p20130222/test/得利卡-車頂燈架 - 複製/成品版本/生產單_22.10.26/焊接照片/1794E184-5D2B-4A6E-A307-405944A45CD0.jpg

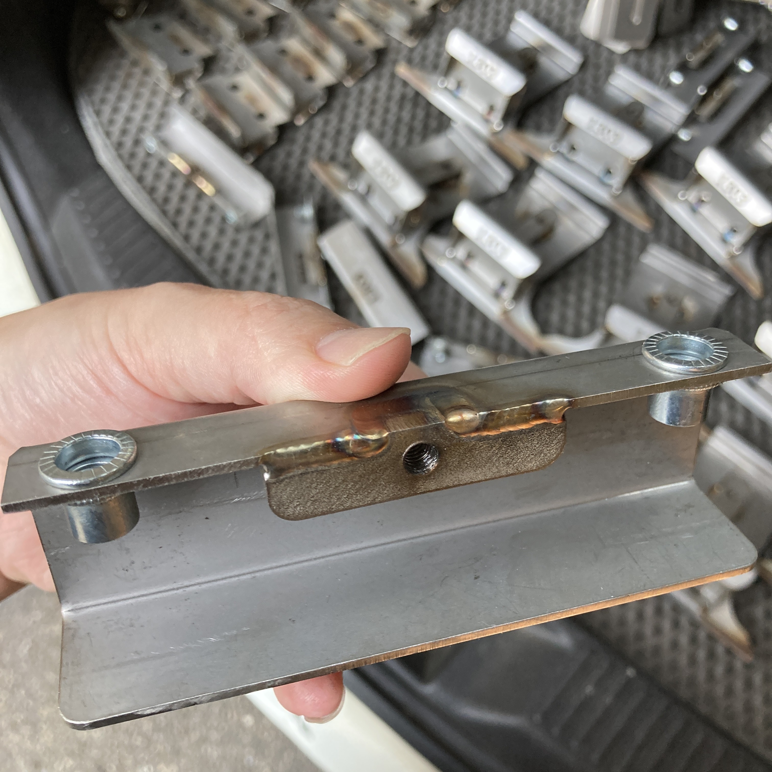
得利卡-車頂燈架 - 複製/成品版本/生產單_22.10.26/焊接照片/1794E184-5D2B-4A6E-A307-405944A45CD0.jpg
