p20130222/test/得利卡-車頂燈架 - 複製/成品版本/生產單_22.10.26/焊接照片/E42CDD00-9727-4BCB-AF38-9A98A2779EEC.jpg

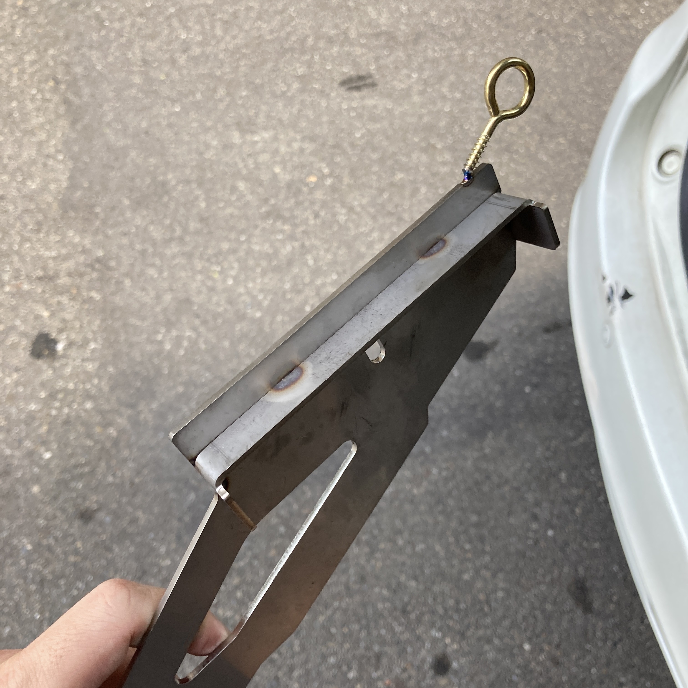
得利卡-車頂燈架 - 複製/成品版本/生產單_22.10.26/焊接照片/E42CDD00-9727-4BCB-AF38-9A98A2779EEC.jpg
