p20130222/test/得利卡-車頂燈架 - 複製/成品版本/生產單_22.07.14/短-車頂燈架-組合(v220714)/加工說明/加工說明.pptx

## 1. 修毛邊【手磨】 ( 海綿砂布 )

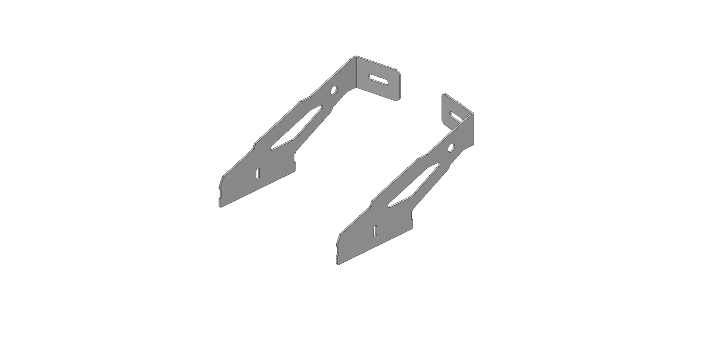
[picture p3: figure]

A 組件

Notes: 1.本體修毛邊

## 1.焊接組件 ( 注意方向 )

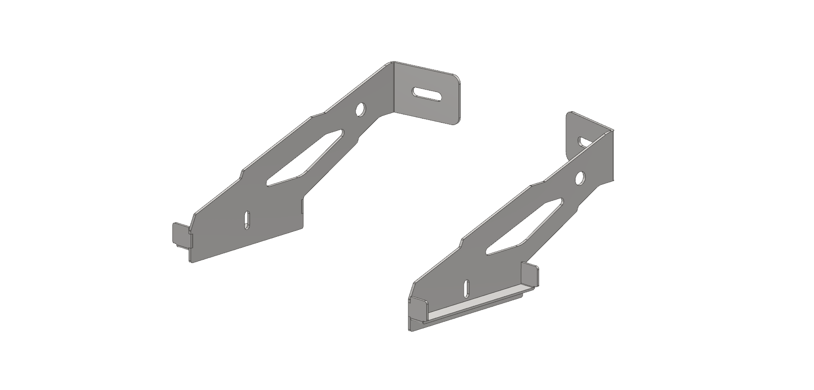
[picture p4: figure]

A 組件

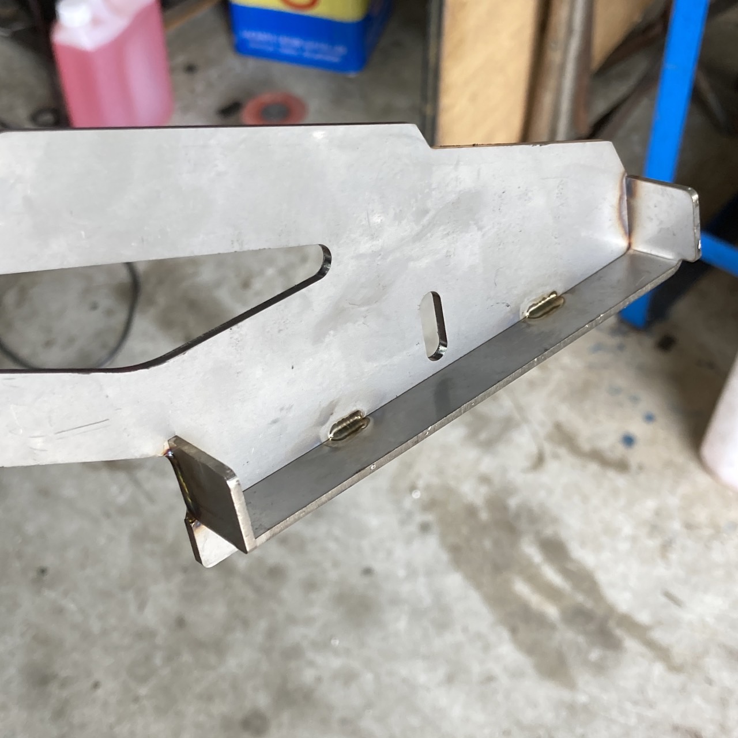
[picture p5: figure]
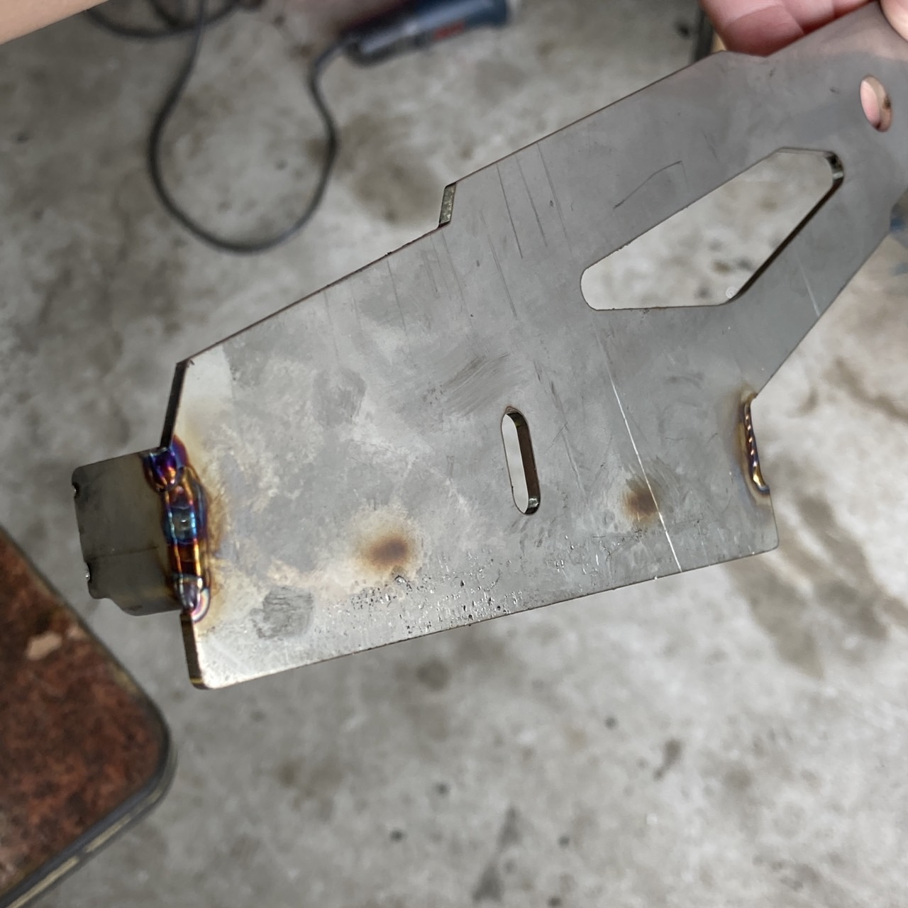
[picture p6: figure]
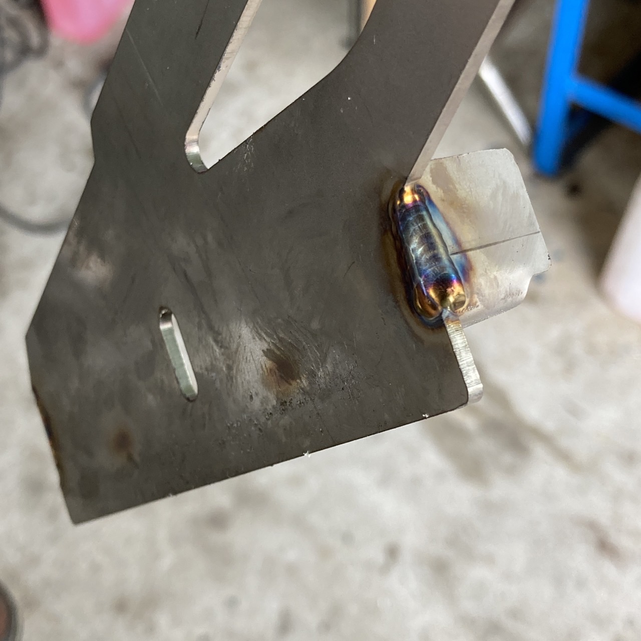
[picture p7: figure]
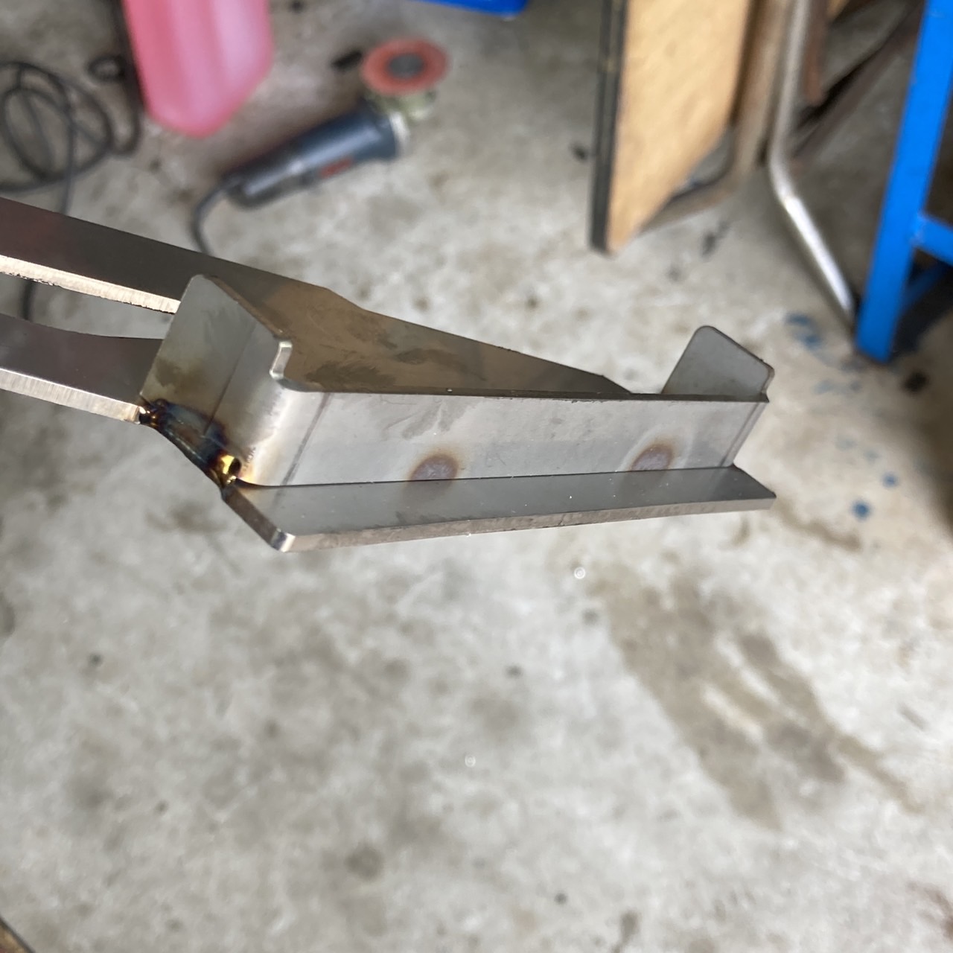
[picture p8: figure]

## 1.焊接羊眼圈 完成

A 組件

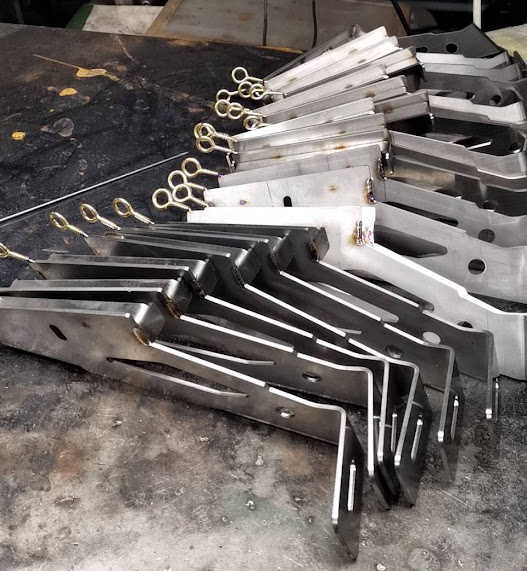
[picture p9: figure]

## 1. 攻牙機攻牙M6

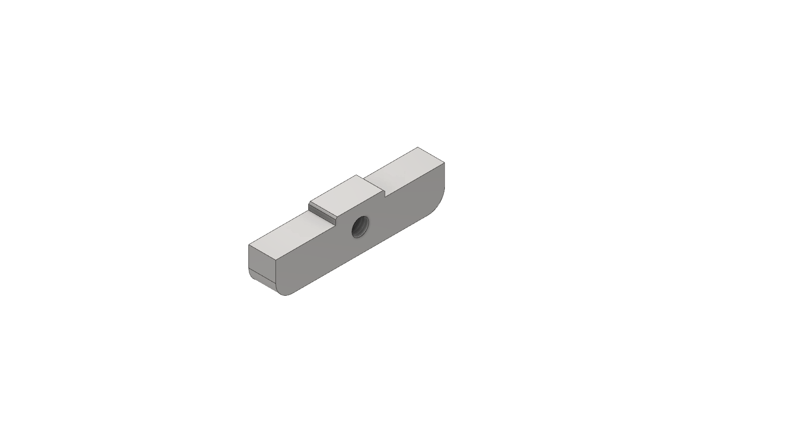
[picture p10: figure]

B組件

Notes: 1. 機器導角單邊
2. 機器攻牙M6

## 1. 本體修毛邊 【機磨】(散打#240 ) 2.鑽孔-拉帽孔擴大為D11 (現為D6 )

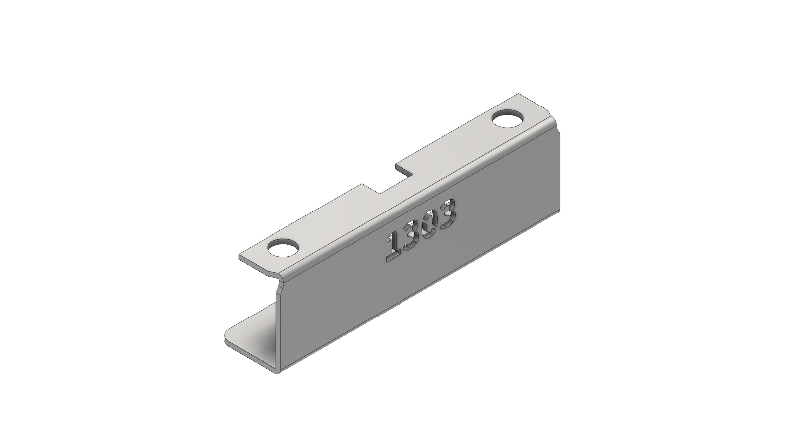
[picture p11: figure]

B組件

Notes: 1.鑽孔-拉帽孔擴大為D11 (現為D10 )

## 1.焊接牙片( 滿焊，注意垂直面 ) 2.牙孔倒角 3.牙孔重新手工攻牙 4.拉上M8拉帽 5.清洗攻牙油 完成

B組件

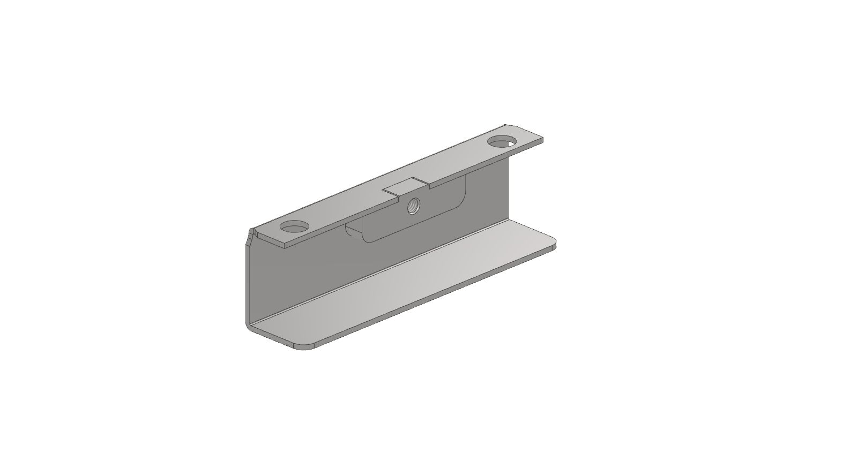
[picture p12: figure]
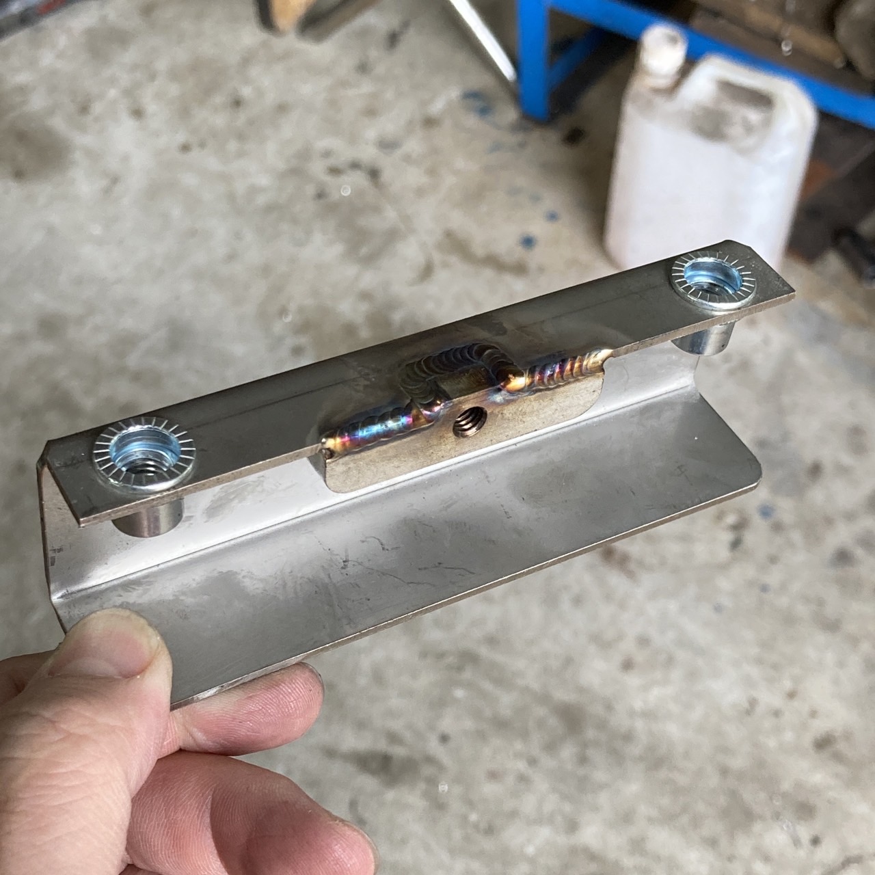
[picture p13: figure]

Notes: 1. 焊接牙片(滿焊)
2.牙孔倒角
3.牙孔重新手工攻牙

## Slide 7

B組件

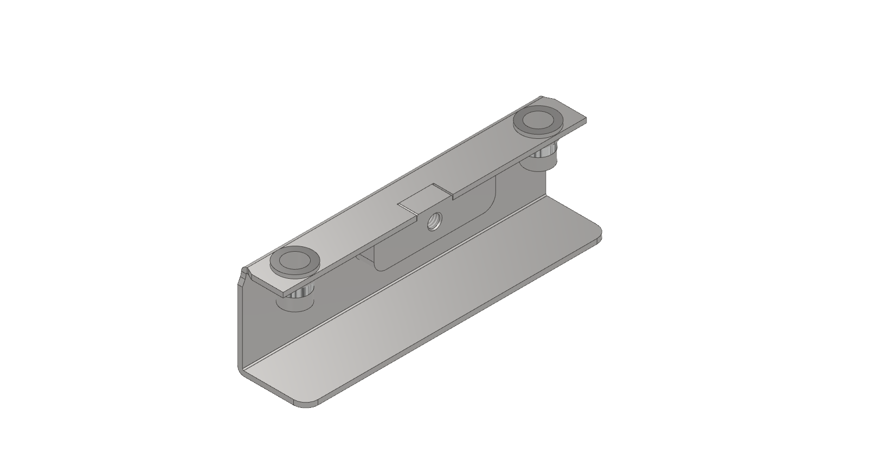
[picture p14: figure]

A組件

Notes: 拉上拉帽
點焊拉帽
清洗攻牙油

## 烤漆前處理 1.賭塞牙孔-寄上烤漆用螺絲 2.送烤漆 3.烤漆完成後折斷羊眼釘 完成

Notes: 1.賭塞牙孔-寄上烤漆用螺絲
2.送烤漆
3.烤漆完成後折斷羊眼釘

## Slide 9

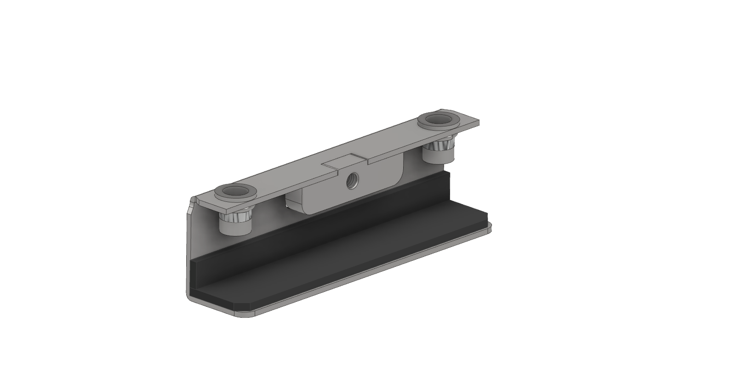
[picture p15: figure]
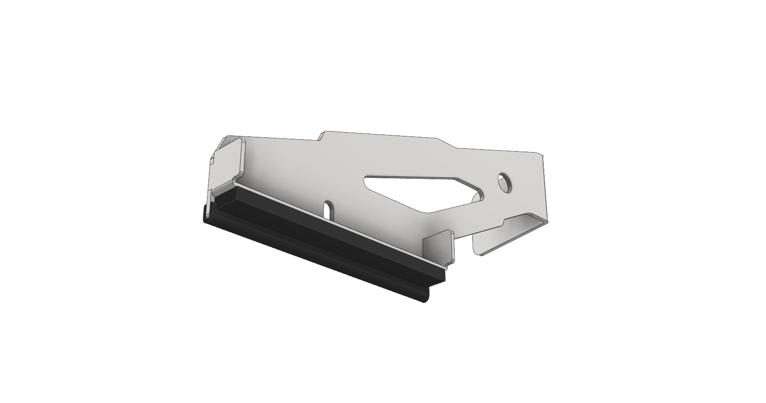
[picture p16: figure]

Notes: 1.黏貼軟墊、U形條

## Slide 10

Notes: 1.鎖上螺絲 ( 不上螺絲膠)
