p20130222/test/得利卡-車頂燈架 - 複製/成品版本/生產單_22.07.14/短-車頂燈架-組合(v220714)/加工說明/排燈架加工說明.pdf

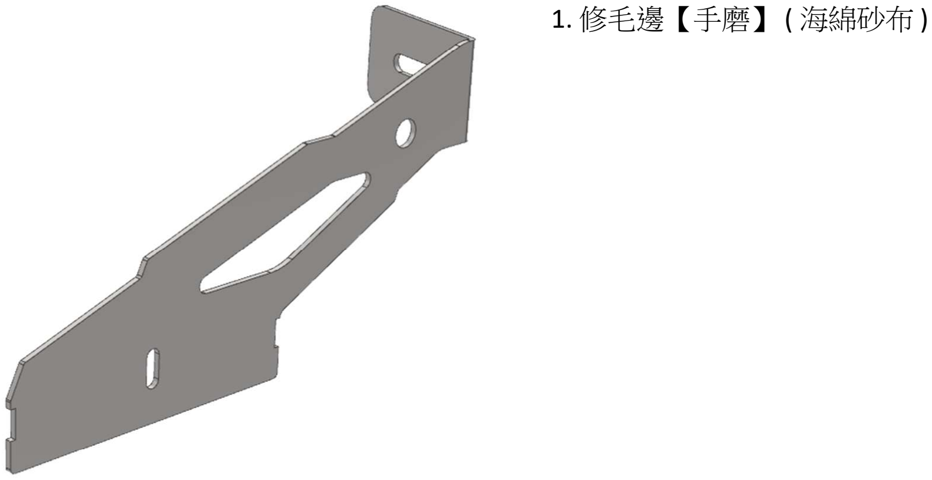
[picture p17: page 1]

### 1. 修毛邊【手磨】 ( 海綿砂布 )

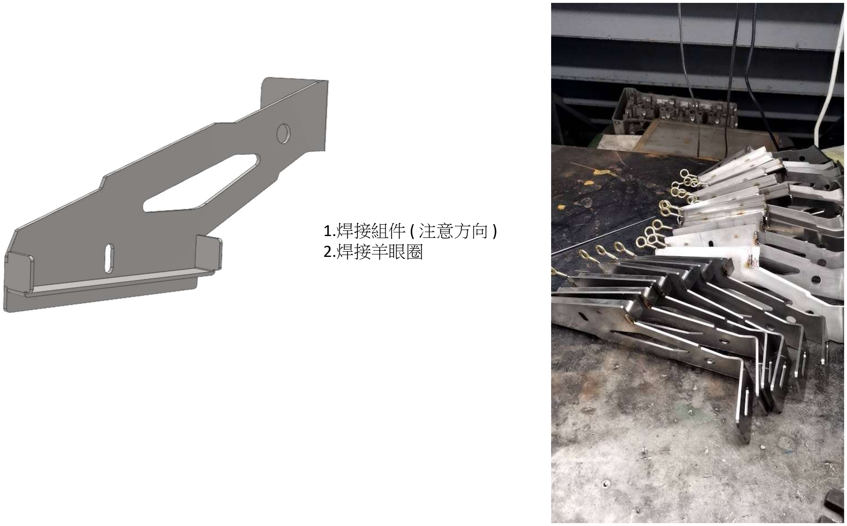
[picture p18: page 2]

1.焊接組件 ( 注意方向 )
2.焊接羊眼圈

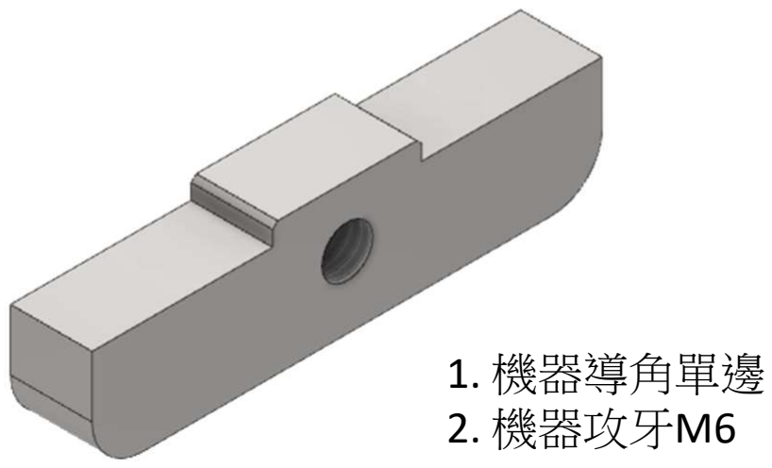
[picture p19: page 3]

### 1. 機器導角單邊

### 2. 機器攻牙M6

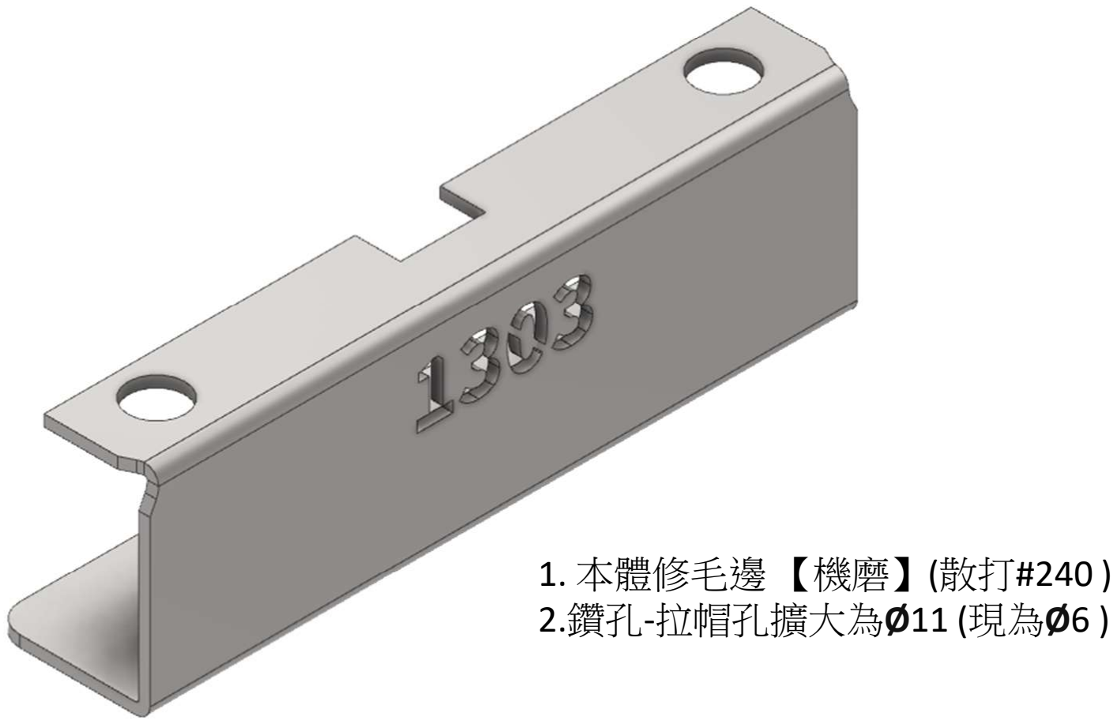
[picture p20: page 4]

### 1. 本體修毛邊 【機磨】(散打#240 )

### 2.鑽孔-拉帽孔擴大為Ø11 (現為Ø6 )

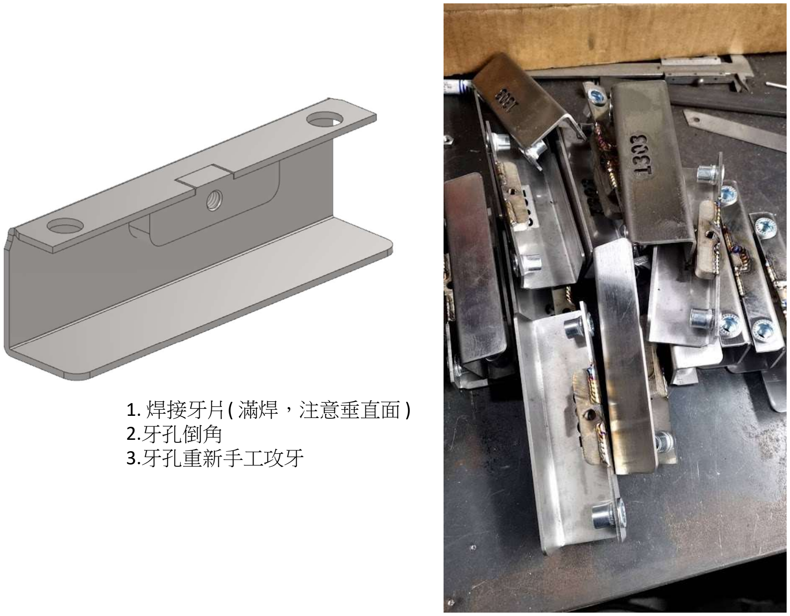
[picture p21: page 5]

### 1. 焊接牙片( 滿焊，注意垂直面 )

2.牙孔倒角
3.牙孔重新手工攻牙

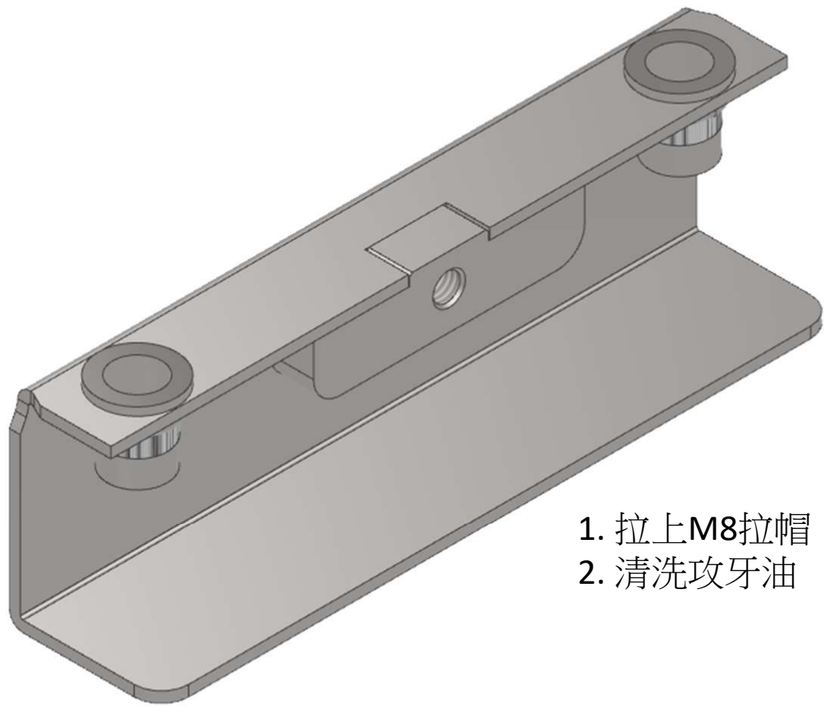
[picture p22: page 6]

### 1. 拉上M8拉帽

### 2. 清洗攻牙油
