p20130222/test/得利卡-車頂燈架 - 複製/IMG_3658.jpg

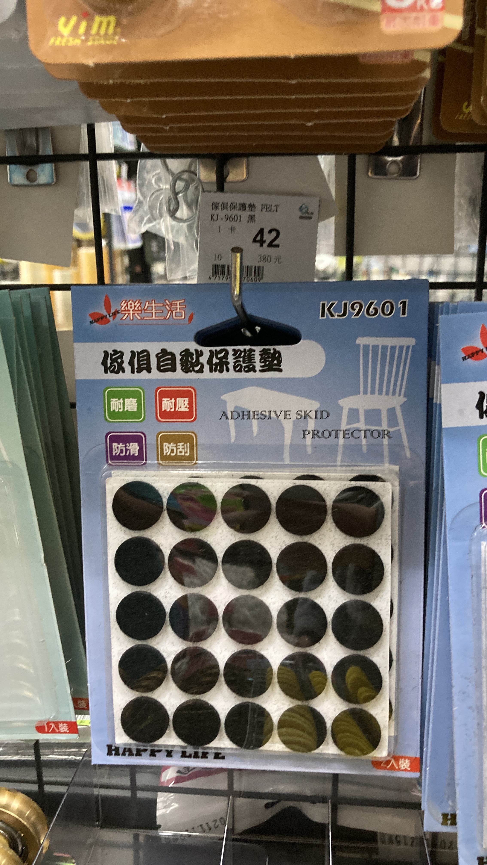
得利卡-車頂燈架 - 複製/IMG_3658.jpg
