p20130222/test/得利卡-車頂燈架 - 複製/成品版本/成品-膠墊使用後情境.jpg

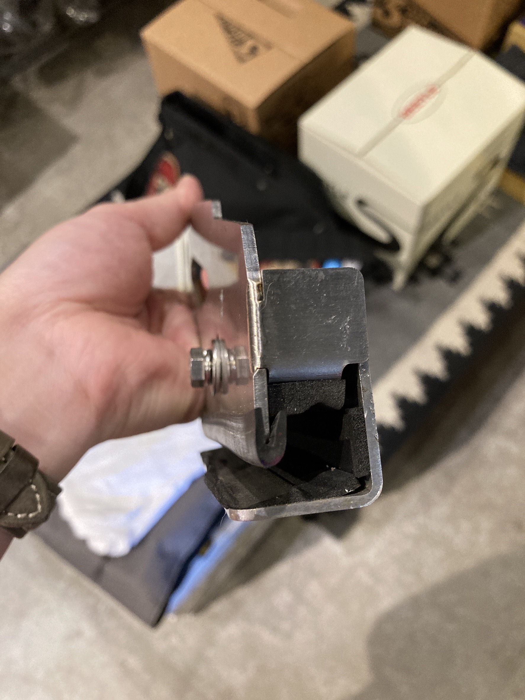
得利卡-車頂燈架 - 複製/成品版本/成品-膠墊使用後情境.jpg
