p20130222/test/得利卡-車頂燈架 - 複製/成品版本/生產單_22.01.05/下單郵件附件.jpg

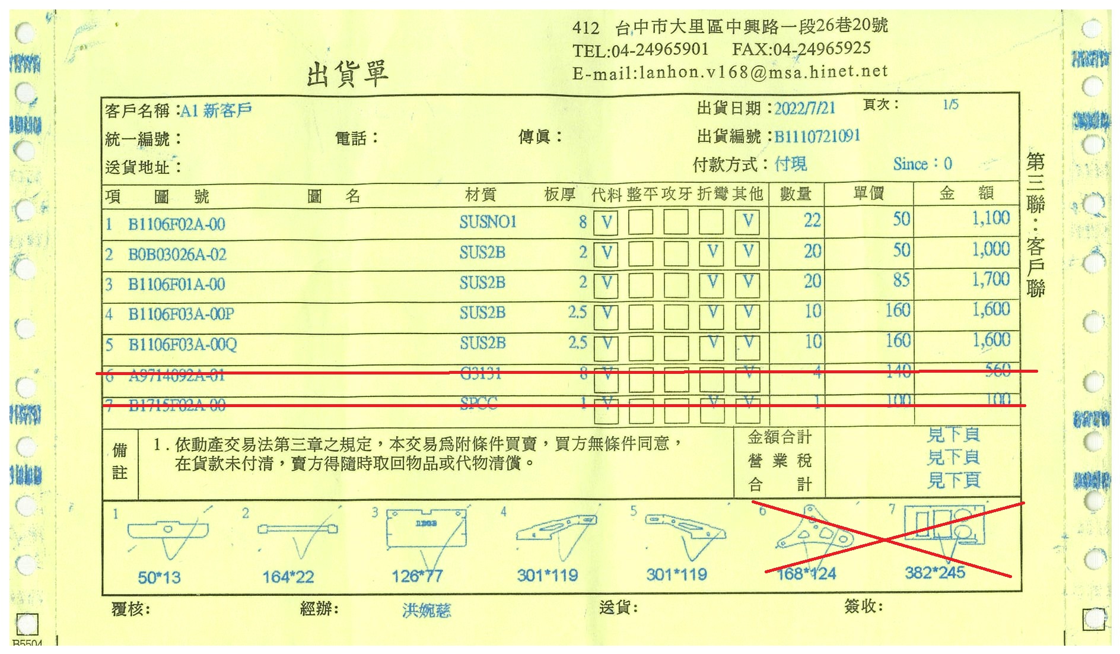
得利卡-車頂燈架 - 複製/成品版本/生產單_22.01.05/下單郵件附件.jpg
