p20130222/test/得利卡-車頂燈架 - 複製/成品版本/生產單_22.07.14/短-車頂燈架-組合(v220714)/加工說明/IMG_3508.JPG

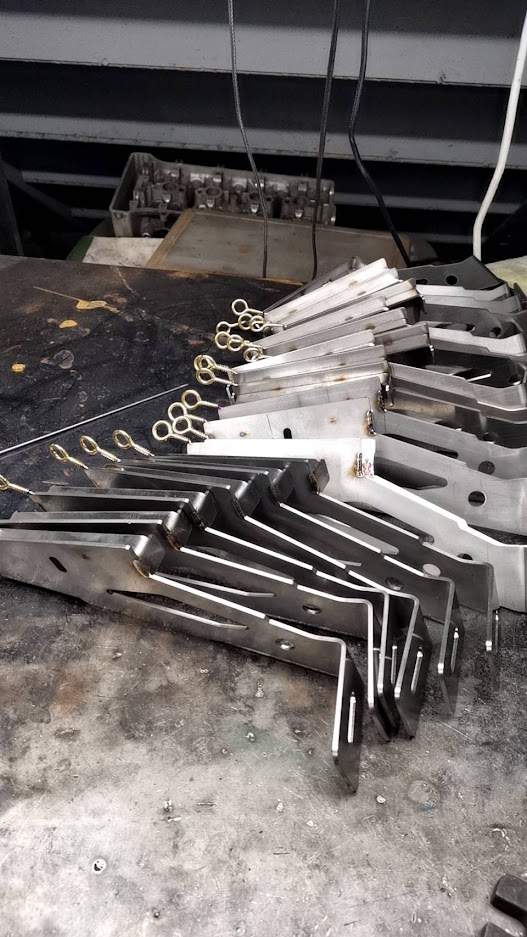
得利卡-車頂燈架 - 複製/成品版本/生產單_22.07.14/短-車頂燈架-組合(v220714)/加工說明/IMG_3508.JPG
