p20130222/test/得利卡-車頂燈架 - 複製/成品版本/生產單_22.10.26/採購物品/寶家 (5).jpg

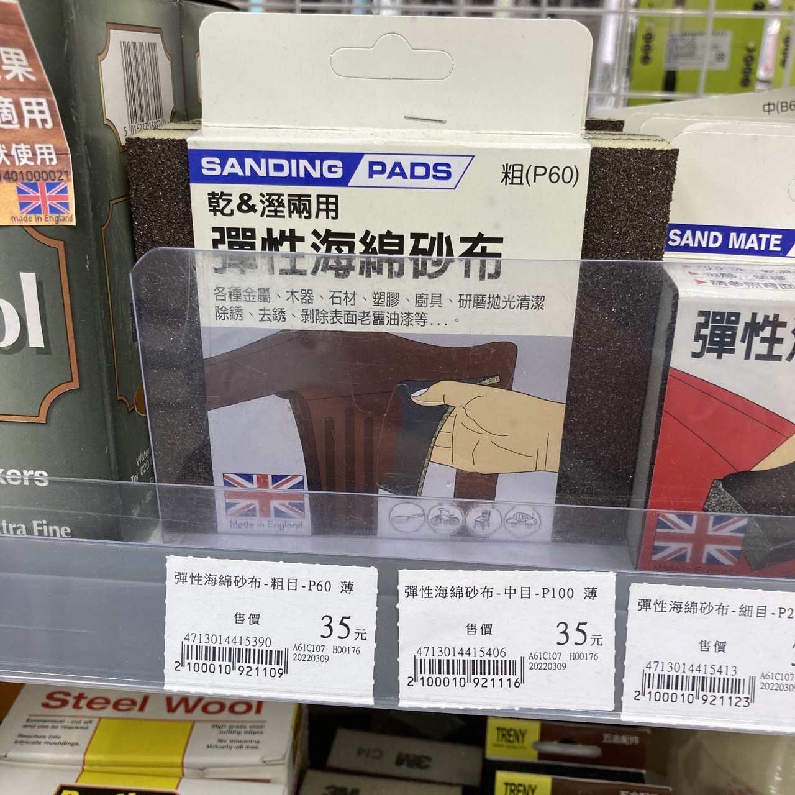
得利卡-車頂燈架 - 複製/成品版本/生產單_22.10.26/採購物品/寶家 (5).jpg
