p20130222/test/得利卡-車頂燈架 - 複製/成品版本/生產單_22.10.26/焊接照片/2563458F-2E07-4B0C-8D35-3437E1A50A45.jpg

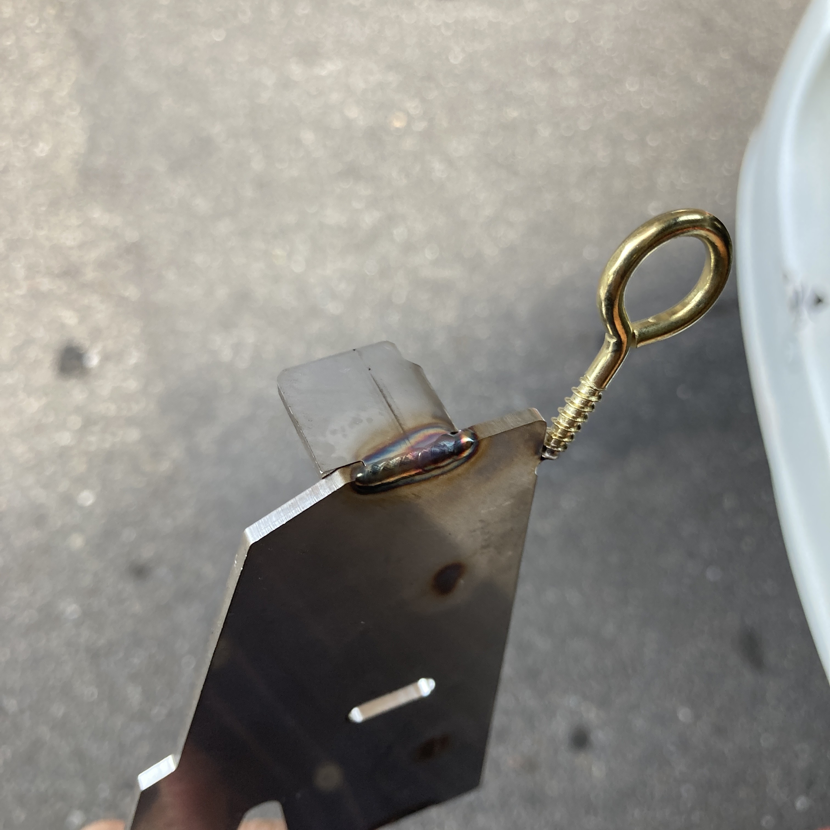
得利卡-車頂燈架 - 複製/成品版本/生產單_22.10.26/焊接照片/2563458F-2E07-4B0C-8D35-3437E1A50A45.jpg
