p20130222/test/得利卡-車頂燈架 - 複製/成品版本/生產單_22.10.26/焊接照片/87878100-F892-40EC-8713-8FCF032992BB.jpg

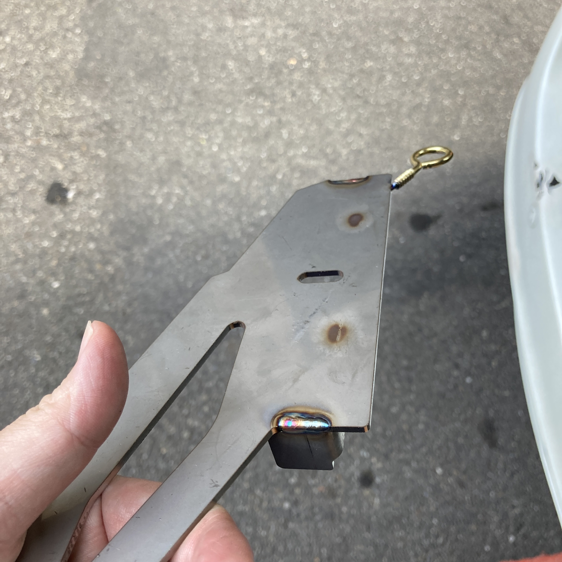
得利卡-車頂燈架 - 複製/成品版本/生產單_22.10.26/焊接照片/87878100-F892-40EC-8713-8FCF032992BB.jpg
