p20130222/test/得利卡-車頂燈架 - 複製/成品版本/生產單_22.10.26/焊接照片/F7BDDE9E-6D32-4605-A794-7535F89AB357.jpg

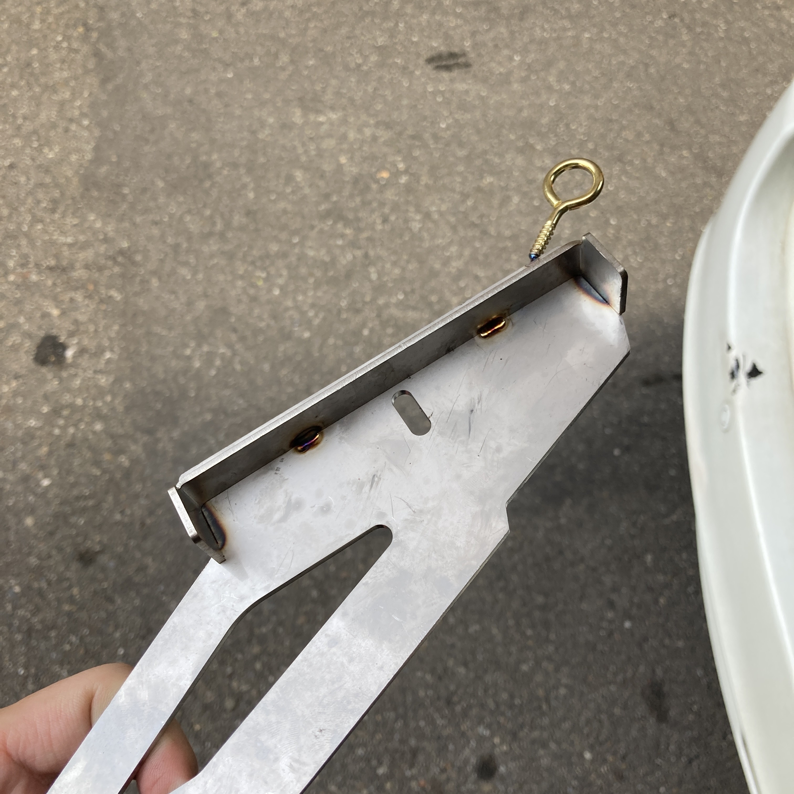
得利卡-車頂燈架 - 複製/成品版本/生產單_22.10.26/焊接照片/F7BDDE9E-6D32-4605-A794-7535F89AB357.jpg
