p20130222/test/得利卡-車頂燈架 - 複製/得利卡-車頂燈架.xlsx

Sheet: 22.10.26_車頂燈架-報價
報 價 單
客戶: | May club |  |  | 專案: |  | 得利卡車頂燈架 |  |  | 報價日期 : |  | 2022.10.26
聯絡人: | Gavin Chiu |  |  | 電 話 : |  |  |  | 傳 真 :
交貨方式: | 配送 |  |  | 送貨地址 : |  | May club 店址
品 名 |  | 項 目 |  |  | 材質 |  | 單位 | 數量 | 單 價 |  | 小 計
得利卡車頂燈架 |  | 吊架-短 (R)、(L) |  |  | 白鐵 / 2.5mm |  | 組 | 10 | 2210 |  | 22100
版本: (#01.05) |  | 烤漆 - 砂面消光黑
注意事項 * 拉帽加工，需特別留意 * M6牙片機器攻牙後，焊接，再重複手攻牙
備註: *無開立發票 交期: 下單後預計天數 15~20 工作天
 |  |  |  |  |  |  |  |  | 總計 | $22100
車頂燈架 - 短 (R)、(L)
版本: (#01.05)
匯款資料 |  |  | 備註
銀行帳戶 | 822 | 中國信託 | 1.本報價單經報價單位簽章後始生效。
銀行帳號 | 9015-6030-1539 |  | 2.以上報價經貴公司代表人、採購窗口簽認回傳後，即視為正式訂購單契約始生效。
戶名 | 柯舜傑 |  | 3. 報價有效期限 / 2個月
付款方式
訂單內容確認無誤後，支付訂金50%以完成下單開始執行生產。 交貨時支付尾款。
 |  |  |  |  |  |  |  | 007
聯絡方式 |  |  |  |  |  |  | 客戶確認簽章 / 日期
手機: | 0970-798-959
Line ID : | p71042013
E-mail : | p20130222@gmail.com

Sheet: 22.07.12_車頂燈架-報價
報 價 單
客戶: | May club |  |  | 專案: |  | 得利卡車頂燈架 |  |  | 報價日期 : |  | 2022.07.12
聯絡人: | Gavin Chiu |  |  | 電 話 : |  |  |  | 傳 真 :
交貨方式: | 配送 |  |  | 送貨地址 : |  | May club 店址
品 名 |  | 項 目 |  |  | 材質 |  | 單位 | 數量 | 單 價 |  | 小 計
得利卡車頂燈架 |  | 吊架-短 (R)、(L) |  |  | 白鐵 / 2.5mm |  | 組 | 10 | 1860 |  | 18600
版本: (#01.05) |  | 烤漆 - 砂面消光黑 |  |  |  |  | 組 | 10 | 350 |  | 3500
備註: *無開立發票 交期: 下單後預計天數 15~20 工作天
 |  |  |  |  |  |  |  |  | 總計 | $22100
車頂燈架 - 短 (R)、(L)
版本: (#01.05)
匯款資料 |  |  | 備註
銀行帳戶 | 822 | 中國信託 | 1.本報價單經報價單位簽章後始生效。
銀行帳號 | 9015-6030-1539 |  | 2.以上報價經貴公司代表人、採購窗口簽認回傳後，即視為正式訂購單契約始生效。
戶名 | 柯舜傑 |  | 3. 報價有效期限 / 2個月
付款方式
訂單內容確認無誤後，支付訂金50%以完成下單開始執行生產。 交貨時支付尾款。
 |  |  |  |  |  |  |  | 007
聯絡方式 |  |  |  |  |  |  | 客戶確認簽章 / 日期
手機: | 0970-798-959
Line ID : | p71042013
E-mail : | p20130222@gmail.com

Sheet: 22.01.04_車頂燈架-報價
報 價 單
客戶: | May club |  |  | 專案: |  | 得利卡車頂燈架 |  |  | 報價日期 : |  | 2022.01.04
聯絡人: | Gavin Chiu |  |  | 電 話 : |  |  |  | 傳 真 :
交貨方式: | 配送 |  |  | 送貨地址 : |  | May club 店址
品 名 |  | 項 目 |  |  | 材質 |  | 單位 | 數量 | 單 價 |  | 小 計
得利卡車頂燈架 |  | 吊架-短 (R)、(L) |  |  | 白鐵 / 2.5mm |  | 組 | 10 | 1860 |  | 18600
 |  | 烤漆 - 砂面消光黑 |  |  |  |  | 組 | 10 | 350 |  | 3500
備註: *無開立發票 交期: 下單後預計天數 15~20 工作天
 |  |  |  |  |  |  |  |  | 總計 | $22100
車頂燈架 - 短 (R)、(L)
匯款資料 |  |  | 備註
銀行帳戶 | 822 | 中國信託 | 1.本報價單經報價單位簽章後始生效。
銀行帳號 | 9015-6030-1539 |  | 2.以上報價經貴公司代表人、採購窗口簽認回傳後，即視為正式訂購單契約始生效。
戶名 | 柯舜傑 |  | 3. 報價有效期限 / 2個月
付款方式
訂單內容確認無誤後，支付訂金50%以完成下單開始執行生產。 交貨時支付尾款。
 |  |  |  |  |  |  |  | 007
聯絡方式 |  |  |  |  |  |  | 客戶確認簽章 / 日期
手機: | 0970-798-959
Line ID : | p71042013
E-mail : | p20130222@gmail.com

Sheet: 21.11.23_車頂燈架-報價
報 價 單
客戶: | May club |  |  | 專案: |  | 得利卡車頂燈架 |  |  |  | 報價日期 : |  | 2021.11.23
聯絡人: | Gavin Chiu |  |  | 電 話 : |  |  |  | 傳 真 :
交貨方式: | 配送 |  |  | 送貨地址 : |  | May club 店址
品 名 |  | 項 目 |  |  | 材質 |  | 單位 | 數量 |  | 單 價 |  | 小 計
得利卡車頂燈架 |  | 吊架-長 (R)、(L) |  |  | 白鐵砂紋 / 2.5mm |  | 組 | 5 |  | 1980 |  | 9900
得利卡車頂燈架 |  | 吊架-短 (R)、(L) |  |  | 白鐵砂紋 / 2.5mm |  | 組 | 5 |  | 1860 |  | 9300
以下空白
備註: *無開立發票 *製圖費為單一次收費 交期: 下單後預計天數 7~14天
 |  |  |  |  |  |  |  |  |  | 總計 | $19200
車頂燈架 - 長 (R)、(L) |  |  |  | 車頂燈架 - 短 (R)、(L) |  |  |  |  | Logo / 1303
匯款資料 |  |  | 備註
銀行帳戶 | 822 | 中國信託 | 1.本報價單經報價單位簽章後始生效。
銀行帳號 | 9015-6030-1539 |  | 2.以上報價經貴公司代表人、採購窗口簽認回傳後，即視為正式訂購單契約始生效。
戶名 | 柯舜傑 |  | 3. 報價有效期限 / 2個月
付款方式
訂單內容確認無誤後，支付訂金50%以完成下單開始執行生產。 交貨時支付尾款。
 |  |  |  |  |  |  |  | 007
聯絡方式 |  |  |  |  |  |  | 客戶確認簽章 / 日期
手機: | 0970-798-959
Line ID : | p71042013
E-mail : | p20130222@gmail.com

Sheet: 21.10.18_車頂燈架-報價
報 價 單
客戶: | May club |  |  |  | 專案: |  | 得利卡車頂燈架 |  |  | 報價日期 : |  | 2021.10.18
聯絡人: | Gavin Chiu |  |  |  | 電 話 : |  |  |  | 傳 真 :
交貨方式: | 配送 |  |  |  | 送貨地址 : |  | May club 店址
品 名 |  | 項 目 |  |  |  | 材質 |  | 單位 | 數量 | 單 價 |  | 小 計
得利卡車頂燈架 |  | 吊架-長 (R)、(L) |  |  |  | 白鐵砂紋 / 2.5mm |  | 組 | 1 | 2300 |  | 2300
得利卡車頂燈架 |  | 吊架-短 (R)、(L) |  |  |  | 白鐵砂紋 / 2.5mm |  | 組 | 1 | 2100 |  | 2100
製圖費 |  |  |  |  |  |  |  | 次 | 1 | 3800 |  | 3800
*後續量產單價可議*
備註: *無開立發票 *製圖費為單一次收費 交期: 下單後預計天數 7~14天
 |  |  |  |  |  |  |  |  |  | 總計 | $8200
車頂燈架 - 長 (R)、(L) |  |  | 車頂燈架 - 短 (R)、(L) |  |  |  | Logo / 1303
匯款資料 |  |  |  | 備註
銀行帳戶 | 822 | 中國信託 |  | 1.本報價單經報價單位簽章後始生效。
銀行帳號 | 9015-6030-1539 |  |  | 2.以上報價經貴公司代表人、採購窗口簽認回傳後，即視為正式訂購單契約始生效。
戶名 | 柯舜傑 |  |  | 3. 報價有效期限 / 2個月
付款方式
訂單內容確認無誤後，支付訂金50%以完成下單開始執行生產。 交貨時支付尾款。
 |  |  |  |  |  |  |  |  | 007
聯絡方式 |  |  |  |  |  |  |  | 客戶確認簽章 / 日期
手機: | 0970-798-959
Line ID : | p71042013
E-mail : | p20130222@gmail.com

Sheet: 日誌
日誌
日期 | 類別 | 項目 | 成果 | 數量 | 款項 | 備註 | 處置 | 位址
 |  |  |  |  | 待收
 |  |  |  |  | 已收訂金
 |  |  |  |  | 貨款付清
 |  |  |  |  | 請選擇
21.11.01 | 交貨 | 1.樣品-吊架-短 | 樣品失敗 | 1 pair |  | 缺失 / 夾持外翻 ，有脫落風險 | 設計變更重製 | 歸檔
 |  | 2.樣品-吊架-長 | 樣品失敗 | 1 pair |  | 缺失 / 夾持外翻 ，有脫落風險 | 設計變更重製 | 歸檔
21.11.23 | 交貨 | 1.樣品-短-車頂燈架-組合(#11.02) | 樣品完成 | 1 pair |  | 無 | 下定量產 10 pair
 |  | 2.樣品-長-車頂燈架-組合(#11.02) | 樣品失敗 | 1 pair |  | 缺失 / 剛性不足 | 設變縮短。 增加結構剛性。
21.11.22 | 交貨 | 1.樣品-吊架-長(#11.26) | 樣品完成 | 1 pair |  | 報價變更【 車頂燈架/ 長 】 * 價格變更 原= 1對/$1980 ，調整為1對/$2200 | 經手工修改底度寬度。 原13mm，改為10.5
21.11.24 | 交貨 | 1.成品-短-車頂燈架-組合(#11.02) | 成品交貨 | 10 pair |  | ( 些微部分NG
22.01.04 | 下單 | 1.短-車頂燈架-組合(#11.02) | 量產品生產 | 10 pair | 貨款付清

Sheet: 材料採購
 | 車頂燈架 (L、R邊) *10組材料
焊接材料 | 國棟五金行
 | 材質 | 名稱 | 規格 | 數量/pcs |  | 用途 | 價格
 |  | 羊眼釘 | 6mm孔 (一包5入) | 4+1 |  | 焊接用 ( 烤漆吊掛治具 )
包裝材料 | 玉豐螺絲行
 | 材質 | 名稱 | 規格 | pcs +放數 |  | 備註 | 價格
 | 白鐵 | 止付螺絲 | M8*20 | 40+2
 | 白鐵 | 外六角螺絲 | M6*20 | 20+5
 | 白鐵 | 平面滑司 | 7-16-2t | 20+5
 | 白鐵 | 彈簧滑司 | 6mm用 | 20+5
 | 國棟五金行
 | 材質 | 名稱 | 規格 | 數量/pcs | 裁切 | 備註 / 需求
 | 軟式 | ㄇ條 |  | 1 | 3000 mm | 【130mm】 *20份 =總2600 mm
 |  | 背膠海綿EVA | 6*30 一捲10米 | 1 |  | 【寬30*長125mm】= 1250 mm。 *10份 [ 寬度對切 ] 得20份
 |  | 背膠海綿EVA 零售切 | 3*20 | 1 | 1500 mm | 【寬20*長125mm】= 1250 mm。 *10份 [ 寬度對切 ] 得20份
 |  | 背膠海綿EVA 零售切 | 3*25 | 1 | 3000 mm | 【寬25*長125 mm】 *20份 =總2500 mm
 | 振宇五金 永春店
 | 材質 | 名稱 | 規格 | 數量/pcs | 裁切 | 備註 / 需求 | 價格
 |  | 樂生活-家俱自黏保護墊 KJ9601 | 圓形墊*25片 2入 ( 共50片) | 1 | 3000 mm | 貼在車頂用，防螺絲頭碰撞 (一組搭配2片 ) | $42
