p20130222/test/(list of files, cad)

Other CAD files:
得利卡-車頂燈架 - 複製/成品版本/生產單_22.01.05/短-車頂燈架-組合(#01.05)/吊架-短(#01.05)-焊接件-1_成型圖.dwg
得利卡-車頂燈架 - 複製/成品版本/生產單_22.01.05/短-車頂燈架-組合(#01.05)/ㄇ槽-焊接件-1(#01.05).dwg
得利卡-車頂燈架 - 複製/成品版本/生產單_22.01.05/短-車頂燈架-組合(#01.05)/吊架-短(#01.05)-焊接件-1_展開圖.dwg
得利卡-車頂燈架 - 複製/成品版本/生產單_22.01.05/短-車頂燈架-組合(#01.05)/吊架-短(#01.05) - 焊接件-2.dwg
得利卡-車頂燈架 - 複製/成品版本/生產單_22.01.05/短-車頂燈架-組合(#01.05)/ㄇ槽-焊接件-2(#01.05).dwg
得利卡-車頂燈架 - 複製/OLD/模型、圖面/old/21.11.28_生產圖面/焊接組件(全)(#11.02).dwg
得利卡-車頂燈架 - 複製/OLD/模型、圖面/old/烤漆治具-焊接用/烤漆治具-焊接用.dwg
得利卡-車頂燈架 - 複製/OLD/模型、圖面/old/白鐵-失敗版本/吊架組件-ㄇ槽.dwg
得利卡-車頂燈架 - 複製/OLD/模型、圖面/old/短-車頂燈架-組合(#11.02)/21.11.02_生產圖面/吊架-長(#11.02)_成型圖.dwg
得利卡-車頂燈架 - 複製/OLD/模型、圖面/old/短-車頂燈架-組合(#11.02)/焊接組件-1(#11.02).dwg
得利卡-車頂燈架 - 複製/OLD/模型、圖面/old/短-車頂燈架-組合(#11.02)/生產圖面_21.11.26/焊接組件(全)(#11.02).dwg
得利卡-車頂燈架 - 複製/OLD/模型、圖面/版本-吊架-長(#11.26)/OLD/焊接組件-3 ( #11.26).dwg
得利卡-車頂燈架 - 複製/OLD/模型、圖面/版本-吊架-長(#11.26)/發出圖面/焊接組件-3( #11.26)_成型圖.dwg
得利卡-車頂燈架 - 複製/OLD/模型、圖面/補角片(個案處理用)/補角片(圖紙比例-模型空間) - 複製.dwg
得利卡-車頂燈架 - 複製/OLD/詢、報價-資料/OLD/焊接組件(全).dwg
得利卡-車頂燈架 - 複製/OLD/模型、圖面/old/白鐵-失敗版本/吊架-長_成型圖.dwg
得利卡-車頂燈架 - 複製/OLD/模型、圖面/old/短-車頂燈架-組合(#11.02)/21.11.02_生產圖面/吊架組件-ㄇ槽(#11.02).dwg
得利卡-車頂燈架 - 複製/OLD/模型、圖面/old/短-車頂燈架-組合(#11.02)/生產圖面_21.11.26/吊架-短(#11.02)_展開圖.dwg
得利卡-車頂燈架 - 複製/OLD/模型、圖面/OldVersions/#3.0022.ipt
得利卡-車頂燈架 - 複製/OLD/模型、圖面/OldVersions/LOGO-1303字體.0003.ipt
得利卡-車頂燈架 - 複製/OLD/模型、圖面/OldVersions/吊架-#2(短).0037.ipt
得利卡-車頂燈架 - 複製/OLD/模型、圖面/OldVersions/吊架-#2(短.0049.ipt
得利卡-車頂燈架 - 複製/OLD/模型、圖面/OldVersions/吊架-#2(長).0047.ipt
得利卡-車頂燈架 - 複製/OLD/模型、圖面/OldVersions/吊架-#2.0035.ipt
得利卡-車頂燈架 - 複製/OLD/模型、圖面/OldVersions/吊架-#3.0021.ipt
得利卡-車頂燈架 - 複製/OLD/模型、圖面/OldVersions/吊架-短(#11.02).0278.idw
得利卡-車頂燈架 - 複製/OLD/模型、圖面/OldVersions/吊架-短(L)(#11.02)_MIR.0002.ipt
得利卡-車頂燈架 - 複製/OLD/模型、圖面/OldVersions/吊架-短(R)(#11.02).0086.ipt
得利卡-車頂燈架 - 複製/OLD/模型、圖面/OldVersions/吊架-短(R).0004.iam
得利卡-車頂燈架 - 複製/OLD/模型、圖面/OldVersions/吊架-短(R).0054.ipt
得利卡-車頂燈架 - 複製/OLD/模型、圖面/OldVersions/吊架-短.0260.idw
得利卡-車頂燈架 - 複製/OLD/模型、圖面/OldVersions/吊架-組件.0231.idw
得利卡-車頂燈架 - 複製/OLD/模型、圖面/OldVersions/吊架-長(#11.----.0273.idw
得利卡-車頂燈架 - 複製/OLD/模型、圖面/OldVersions/吊架-長(#11.02).0272.idw
得利卡-車頂燈架 - 複製/OLD/模型、圖面/OldVersions/吊架-長(#11.26).0279.idw
得利卡-車頂燈架 - 複製/OLD/模型、圖面/OldVersions/吊架-長(L)(#11.02)_MIR.0001.ipt
得利卡-車頂燈架 - 複製/OLD/模型、圖面/OldVersions/吊架-長(R)(#11.26).0068.ipt
得利卡-車頂燈架 - 複製/OLD/模型、圖面/OldVersions/吊架-長(R).0050.ipt
得利卡-車頂燈架 - 複製/OLD/模型、圖面/OldVersions/吊架-長.0003.iam
得利卡-車頂燈架 - 複製/OLD/模型、圖面/OldVersions/吊架-長.0263.idw
得利卡-車頂燈架 - 複製/OLD/模型、圖面/OldVersions/吊架組件-ㄇ槽(#11.02).0113.ipt
得利卡-車頂燈架 - 複製/OLD/模型、圖面/OldVersions/吊架組件-ㄇ槽(#11.02).0248.idw
得利卡-車頂燈架 - 複製/OLD/模型、圖面/OldVersions/吊架組件-ㄇ槽.0088.ipt
得利卡-車頂燈架 - 複製/OLD/模型、圖面/OldVersions/吊架組件-ㄇ槽.0244.idw
得利卡-車頂燈架 - 複製/OLD/模型、圖面/OldVersions/差異對比.0046.iam
得利卡-車頂燈架 - 複製/OLD/模型、圖面/OldVersions/差異比較-黑鐵、白鐵.0007.iam
得利卡-車頂燈架 - 複製/OLD/模型、圖面/OldVersions/得利卡-車頂導水槽-修正版.0014.ipt
得利卡-車頂燈架 - 複製/OLD/模型、圖面/OldVersions/得利卡-車頂導水槽.0024.ipt
得利卡-車頂燈架 - 複製/OLD/模型、圖面/OldVersions/概-泡棉墊#3.0007.ipt
得利卡-車頂燈架 - 複製/OLD/模型、圖面/OldVersions/概-泡棉墊(1).0007.ipt
得利卡-車頂燈架 - 複製/OLD/模型、圖面/OldVersions/概-泡棉墊(2).0010.ipt
得利卡-車頂燈架 - 複製/OLD/模型、圖面/OldVersions/概-泡棉墊(3).0013.ipt
得利卡-車頂燈架 - 複製/OLD/模型、圖面/OldVersions/概-車頂導水槽-#2.0013.ipt
得利卡-車頂燈架 - 複製/OLD/模型、圖面/OldVersions/模型試組---( 車頂燈架 ).0249.iam
得利卡-車頂燈架 - 複製/OLD/模型、圖面/OldVersions/焊接、包裝筆記- 短、長-車頂燈架(#11.02).0425.iam
得利卡-車頂燈架 - 複製/OLD/模型、圖面/OldVersions/焊接筆記- 短、長-車頂燈架(#11.02).0401.iam
得利卡-車頂燈架 - 複製/OLD/模型、圖面/OldVersions/焊接組件(全)(#11.02).0262.idw
得利卡-車頂燈架 - 複製/OLD/模型、圖面/OldVersions/焊接組件(全).0233.idw
得利卡-車頂燈架 - 複製/OLD/模型、圖面/OldVersions/焊接組件(全).0259.idw
得利卡-車頂燈架 - 複製/OLD/模型、圖面/OldVersions/焊接組件-1(#11.02).0055.ipt
得利卡-車頂燈架 - 複製/OLD/模型、圖面/OldVersions/焊接組件-1.0016.ipt
得利卡-車頂燈架 - 複製/OLD/模型、圖面/OldVersions/焊接組件-2.0019.ipt
得利卡-車頂燈架 - 複製/OLD/模型、圖面/OldVersions/焊接組件-3.0036.ipt
得利卡-車頂燈架 - 複製/OLD/模型、圖面/OldVersions/版本-長、短-對照.0014.iam
得利卡-車頂燈架 - 複製/OLD/模型、圖面/OldVersions/白鐵-吊架-短(R)(#11.02).0084.ipt
得利卡-車頂燈架 - 複製/OLD/模型、圖面/OldVersions/白鐵-吊架-短(R).0059.ipt
得利卡-車頂燈架 - 複製/OLD/模型、圖面/OldVersions/白鐵-吊架-長(R)(#11.02).0064.ipt
得利卡-車頂燈架 - 複製/OLD/模型、圖面/OldVersions/白鐵-吊架-長(R).0059.ipt
得利卡-車頂燈架 - 複製/OLD/模型、圖面/OldVersions/白鐵-吊架組件-ㄇ槽.0096.ipt
得利卡-車頂燈架 - 複製/OLD/模型、圖面/OldVersions/白鐵-焊接組件-1(#11.02).0051.ipt
得利卡-車頂燈架 - 複製/OLD/模型、圖面/OldVersions/白鐵-焊接組件-1.0020.ipt
得利卡-車頂燈架 - 複製/OLD/模型、圖面/OldVersions/白鐵-焊接組件-2(#11.02).0040.ipt
得利卡-車頂燈架 - 複製/OLD/模型、圖面/OldVersions/白鐵-焊接組件-2.0025.ipt
得利卡-車頂燈架 - 複製/OLD/模型、圖面/OldVersions/白鐵-焊接組件-3.0040.ipt
得利卡-車頂燈架 - 複製/OLD/模型、圖面/OldVersions/皓均製造所.0216.idw
得利卡-車頂燈架 - 複製/OLD/模型、圖面/OldVersions/短-車頂燈架-組合(#11.02)- 組合件1.0438.iam
得利卡-車頂燈架 - 複製/OLD/模型、圖面/OldVersions/短-車頂燈架-組合(#11.02)- 組合件2.0435.iam
得利卡-車頂燈架 - 複製/OLD/模型、圖面/OldVersions/短-車頂燈架-組合(#11.02)-總組合.0450.iam
得利卡-車頂燈架 - 複製/OLD/模型、圖面/OldVersions/短-車頂燈架-組合(#11.02).0432.iam
得利卡-車頂燈架 - 複製/OLD/模型、圖面/OldVersions/組件1-#2.0069.ipt
得利卡-車頂燈架 - 複製/OLD/模型、圖面/OldVersions/組件1-#3.0042.ipt
得利卡-車頂燈架 - 複製/OLD/模型、圖面/OldVersions/組合檔.0004.iam
得利卡-車頂燈架 - 複製/OLD/模型、圖面/OldVersions/組裝件.0250.iam
得利卡-車頂燈架 - 複製/OLD/模型、圖面/OldVersions/縮圖用.0217.idw
得利卡-車頂燈架 - 複製/OLD/模型、圖面/OldVersions/草-組合檔-#2.0177.iam
得利卡-車頂燈架 - 複製/OLD/模型、圖面/OldVersions/草-零件 - 複製 (2) - 複製.0026.ipt
得利卡-車頂燈架 - 複製/OLD/模型、圖面/OldVersions/草-零件 - 複製.0010.ipt
得利卡-車頂燈架 - 複製/OLD/模型、圖面/OldVersions/草-零件.0005.ipt
得利卡-車頂燈架 - 複製/OLD/模型、圖面/OldVersions/車身圖.0004.ipt
得利卡-車頂燈架 - 複製/OLD/模型、圖面/OldVersions/車頂燈架-組合 - 複製.0231.iam
得利卡-車頂燈架 - 複製/OLD/模型、圖面/OldVersions/車頂燈架-組合#2.0205.iam
得利卡-車頂燈架 - 複製/OLD/模型、圖面/OldVersions/車頂燈架-組合.0226.iam
得利卡-車頂燈架 - 複製/OLD/模型、圖面/OldVersions/車頂燈架-組合.0251.idw
得利卡-車頂燈架 - 複製/OLD/模型、圖面/OldVersions/車頂燈架短-組合(白鐵).0255.iam
得利卡-車頂燈架 - 複製/OLD/模型、圖面/OldVersions/車頂燈架短-組合(黑鐵).0238.iam
得利卡-車頂燈架 - 複製/OLD/模型、圖面/OldVersions/車頂燈架短-組合.0237.iam
得利卡-車頂燈架 - 複製/OLD/模型、圖面/OldVersions/車頂燈架長-組合(白鐵).0264.iam
得利卡-車頂燈架 - 複製/OLD/模型、圖面/OldVersions/車頂燈架長-組合(黑鐵).0241.iam
得利卡-車頂燈架 - 複製/OLD/模型、圖面/OldVersions/車頂燈架長-組合.0240.iam
得利卡-車頂燈架 - 複製/OLD/模型、圖面/OldVersions/長-車頂燈架-組合(#11.02).0391.iam
得利卡-車頂燈架 - 複製/OLD/模型、圖面/OldVersions/長-車頂燈架-組合(#11.26).0396.iam
得利卡-車頂燈架 - 複製/OLD/模型、圖面/OldVersions/長、短-對照.0011.iam
得利卡-車頂燈架 - 複製/OLD/模型、圖面/OldVersions/長、短-對照.0213.idw
得利卡-車頂燈架 - 複製/OLD/模型、圖面/old/OldVersions/old ( 草-組合檔 ).0102.iam
得利卡-車頂燈架 - 複製/OLD/模型、圖面/old/OldVersions/組合檔.0001.iam
得利卡-車頂燈架 - 複製/OLD/模型、圖面/old/OldVersions/長-車頂燈架-組合(#11.02).0393.iam
得利卡-車頂燈架 - 複製/OLD/模型、圖面/old/概念/old ( 草-組合檔 ).iam
得利卡-車頂燈架 - 複製/OLD/模型、圖面/old/概念/概-泡棉墊(1).ipt
得利卡-車頂燈架 - 複製/OLD/模型、圖面/old/概念/概-泡棉墊(2).ipt
得利卡-車頂燈架 - 複製/OLD/模型、圖面/old/概念/概-泡棉墊(3).ipt
得利卡-車頂燈架 - 複製/OLD/模型、圖面/old/概念/概-膠墊.ipt
得利卡-車頂燈架 - 複製/OLD/模型、圖面/old/概念/概-膠條.ipt
得利卡-車頂燈架 - 複製/OLD/模型、圖面/old/概念/概-車頂導水槽.ipt
得利卡-車頂燈架 - 複製/OLD/模型、圖面/old/概念/草-零件 - 複製 (2) - 複製.ipt
得利卡-車頂燈架 - 複製/OLD/模型、圖面/old/概念/草-零件 - 複製 (5).ipt
得利卡-車頂燈架 - 複製/OLD/模型、圖面/old/概念/草-零件.ipt
得利卡-車頂燈架 - 複製/OLD/模型、圖面/old/烤漆治具-焊接用/OldVersions/烤漆治具-焊接用.0009.ipt
得利卡-車頂燈架 - 複製/OLD/模型、圖面/old/烤漆治具-焊接用/OldVersions/烤漆治具-焊接用.0346.idw
得利卡-車頂燈架 - 複製/OLD/模型、圖面/old/烤漆治具-焊接用/OldVersions/焊接位置.0010.iam
得利卡-車頂燈架 - 複製/OLD/模型、圖面/old/烤漆治具-焊接用/烤漆治具-焊接用.idw
得利卡-車頂燈架 - 複製/OLD/模型、圖面/old/烤漆治具-焊接用/烤漆治具-焊接用.ipt
得利卡-車頂燈架 - 複製/OLD/模型、圖面/old/版本-吊架-長(#11.02)/吊架-長(#11.02).idw
得利卡-車頂燈架 - 複製/OLD/模型、圖面/old/版本-吊架-長(#11.02)/吊架-長(L)(#11.02)_MIR.ipt
得利卡-車頂燈架 - 複製/OLD/模型、圖面/old/版本-吊架-長(#11.02)/吊架-長(R)(#11.02).ipt
得利卡-車頂燈架 - 複製/OLD/模型、圖面/old/白鐵-失敗版本/吊架-短.idw
得利卡-車頂燈架 - 複製/OLD/模型、圖面/old/白鐵-失敗版本/吊架-短_展開圖.dwg
得利卡-車頂燈架 - 複製/OLD/模型、圖面/old/白鐵-失敗版本/吊架-短_成型圖.dwg
得利卡-車頂燈架 - 複製/OLD/模型、圖面/old/白鐵-失敗版本/吊架-長.idw
得利卡-車頂燈架 - 複製/OLD/模型、圖面/old/白鐵-失敗版本/吊架-長_展開圖.dwg
得利卡-車頂燈架 - 複製/OLD/模型、圖面/old/白鐵-失敗版本/吊架組件-ㄇ槽.idw
得利卡-車頂燈架 - 複製/OLD/模型、圖面/old/白鐵-失敗版本/差異比較-黑鐵、白鐵.iam
得利卡-車頂燈架 - 複製/OLD/模型、圖面/old/白鐵-失敗版本/得利卡-車頂導水槽-修正版.ipt
得利卡-車頂燈架 - 複製/OLD/模型、圖面/old/白鐵-失敗版本/焊接組件(全).dwg
得利卡-車頂燈架 - 複製/OLD/模型、圖面/old/白鐵-失敗版本/焊接組件(全).idw
得利卡-車頂燈架 - 複製/OLD/模型、圖面/old/白鐵-失敗版本/白鐵-吊架-短(L)_MIR.ipt
得利卡-車頂燈架 - 複製/OLD/模型、圖面/old/白鐵-失敗版本/白鐵-吊架-短(R).ipt
得利卡-車頂燈架 - 複製/OLD/模型、圖面/old/白鐵-失敗版本/白鐵-吊架-長(L)_MIR.ipt
得利卡-車頂燈架 - 複製/OLD/模型、圖面/old/白鐵-失敗版本/白鐵-吊架-長(R).ipt
得利卡-車頂燈架 - 複製/OLD/模型、圖面/old/白鐵-失敗版本/白鐵-吊架組件-ㄇ槽.ipt
得利卡-車頂燈架 - 複製/OLD/模型、圖面/old/白鐵-失敗版本/白鐵-吊架組件-ㄇ槽_MIR.ipt
得利卡-車頂燈架 - 複製/OLD/模型、圖面/old/白鐵-失敗版本/白鐵-吊架組件-ㄇ槽_MIR1.ipt
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
