p20130222/test/得利卡-車頂燈架 - 複製/成品版本/生產單_22.01.05/短-車頂燈架-組合(#01.05)/ㄇ槽-焊接件-1(#01.05).pdf

視圖149 ( 1 : 2 )

L

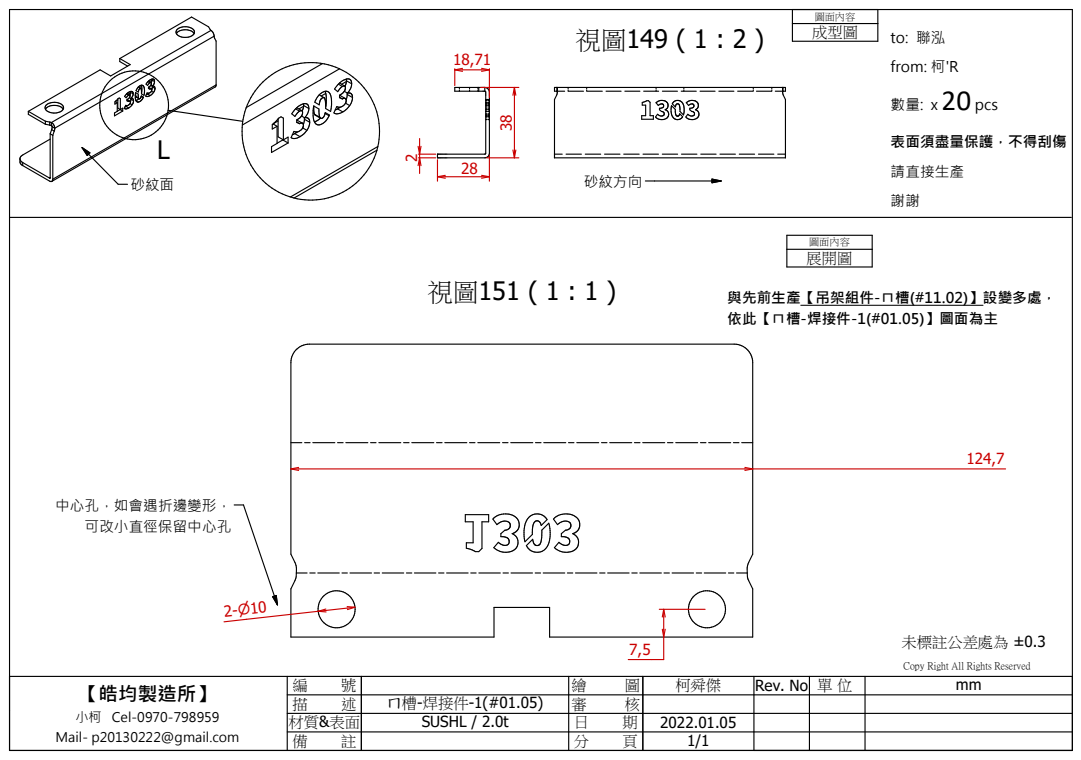
[picture p36: page 1]
未標註公差處為 ±0.3; 圖面內容 成型圖 38; 圖面內容 展開圖; 中心孔，如會遇折邊變形， 可改小直徑保留中心孔; 砂紋面; 砂紋方向; to: 聯泓 from: 柯'R 數量: x 20 pcs; 表面須盡量保護，不得刮傷; 請直接生產 謝謝

與先前生產【吊架組件-ㄇ槽(#11.02)】設變多處，
依此【ㄇ槽-焊接件-1(#01.05)】圖面為主

Copy Right All Rights Reserved

【皓均製造所】 小柯 Cel-0970-798959 Mail- p20130222@gmail.com | 編 號 | | 繪 圖 | 柯舜傑 | Rev. No | 單 位 | mm

描 述 | ㄇ槽-焊接件-1(#01.05) | 審 核
材質&表面 | SUSHL / 2.0t | 日 期 | 2022.01.05
備 註 | | 分 頁 | 1/1
