p20130222/test/得利卡-車頂燈架 - 複製/成品版本/生產單_22.01.05/短-車頂燈架-組合(#01.05)/ㄇ槽-焊接件-2(#01.05).pdf

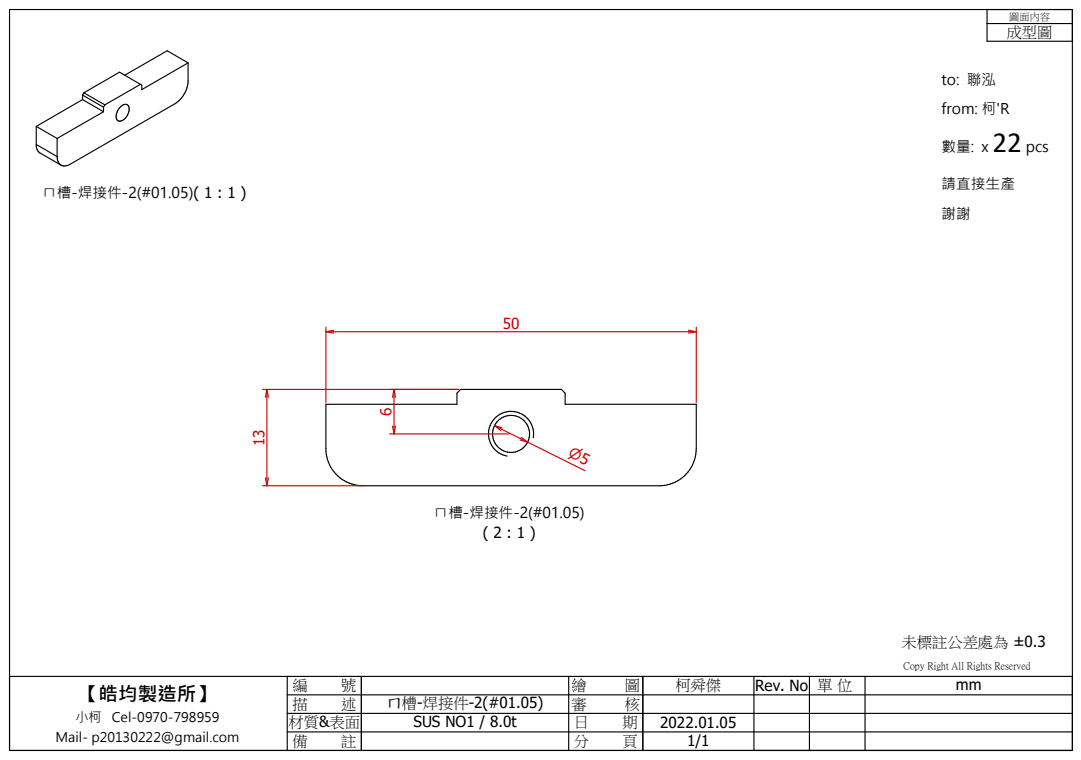
[picture p37: page 1]
ㄇ槽-焊接件-2(#01.05) ( 2 : 1 ); ㄇ槽-焊接件-2(#01.05)( 1 : 1 ); 未標註公差處為 ±0.3; 圖面內容 成型圖; from: 柯'R 數量: x 22 pcs; 請直接生產

Copy Right All Rights Reserved

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

描 述 | ㄇ槽-焊接件-2(#01.05) | 審 核
材質&表面 | SUS NO1 / 8.0t | 日 期 | 2022.01.05
備 註 | | 分 頁 | 1/1
