p20130222/test/得利卡-車頂燈架 - 複製/成品版本/生產單_22.01.05/短-車頂燈架-組合(#01.05)/吊架-短(#01.05) - 焊接件-2.pdf

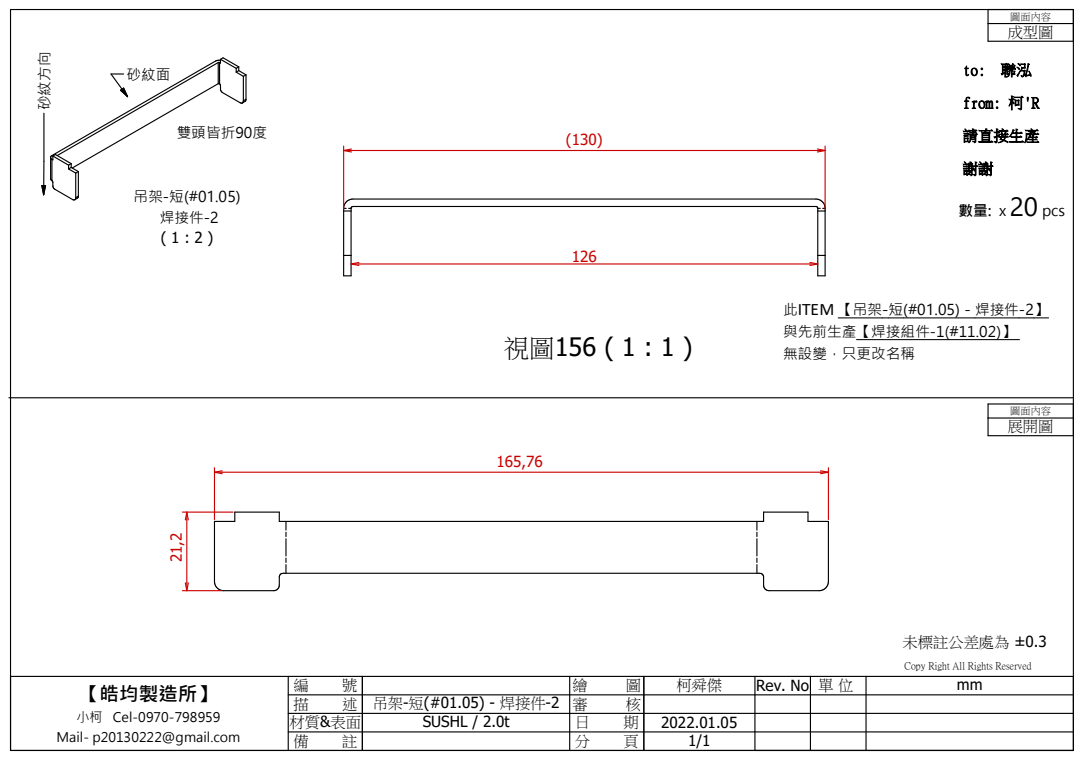
[picture p38: page 1]
吊架-短(#01.05) 焊接件-2 ( 1 : 2 ); 未標註公差處為 ±0.3; from: 柯'R; 請直接生產; 圖面內容 成型圖; 圖面內容 展開圖; 數量: x 20 pcs; 雙頭皆折90度; 砂紋面 砂紋方向

此ITEM 【吊架-短(#01.05) - 焊接件-2】
與先前生產【焊接組件-1(#11.02)】
無設變，只更改名稱

Copy Right All Rights Reserved

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

描 述 | 吊架-短(#01.05) - 焊接件-2 | 審 核
材質&表面 | SUSHL / 2.0t | 日 期 | 2022.01.05
備 註 | | 分 頁 | 1/1
