p20130222/test/得利卡-車頂燈架 - 複製/成品版本/生產單_22.01.05/短-車頂燈架-組合(#01.05)/吊架-短(#01.05)-焊接件-1_a3.pdf

300,73 | 118,57

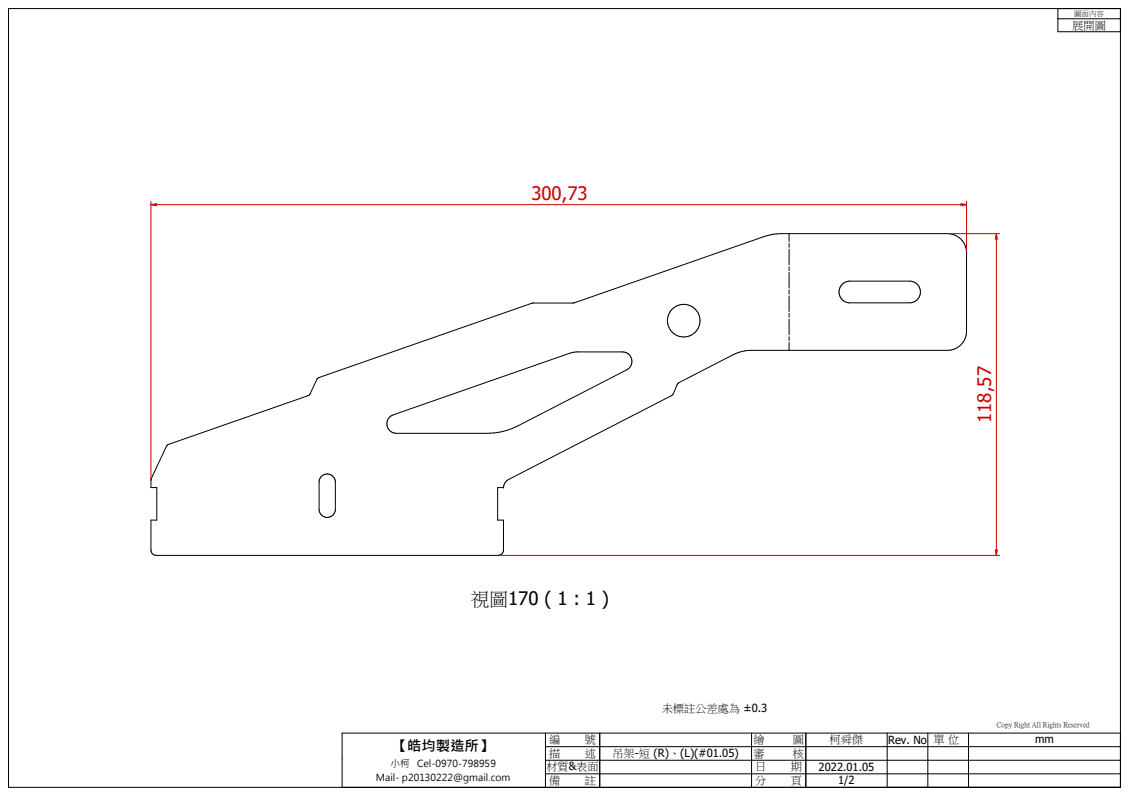
[picture p39: page 1]
未標註公差處為 ±0.3; 圖面內容 展開圖

Copy Right All Rights Reserved

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

描 述 | 吊架-短 (R)、(L)(#01.05) | 審 核
材質&表面 | | 日 期 | 2022.01.05
備 註 | | 分 頁 | 1/2
