p20130222/test/得利卡-車頂燈架 - 複製/成品版本/生產單_22.01.05/短-車頂燈架-組合(#01.05)/吊架-短(#01.05)-焊接件-1_a4.pdf

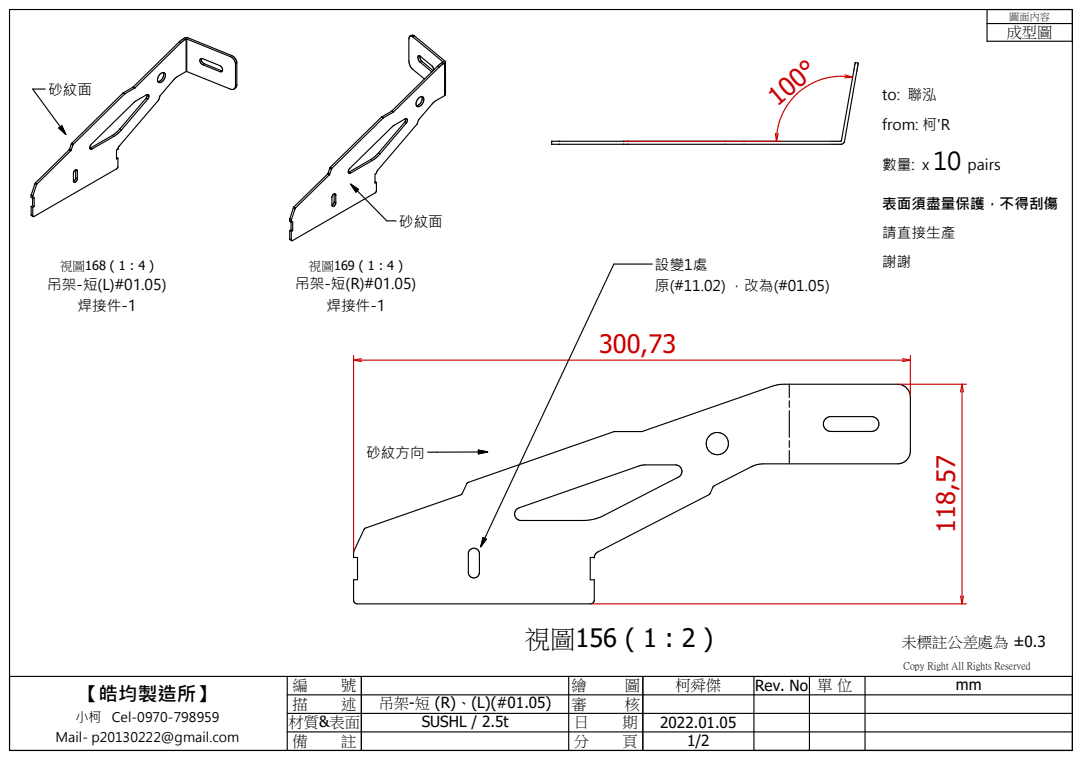
[picture p40: page 1]
視圖168 ( 1 : 4 ) 吊架-短(L)#01.05) 焊接件-1; 視圖169 ( 1 : 4 ) 吊架-短(R)#01.05) 焊接件-1; 未標註公差處為 ±0.3; from: 柯'R; 數量: x 10 pairs; 表面須盡量保護，不得刮傷 請直接生產; 圖面內容 成型圖; 砂紋面; 砂紋方向

Copy Right All Rights Reserved

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

描 述 | 吊架-短 (R)、(L)(#01.05) | 審 核
材質&表面 | SUSHL / 2.5t | 日 期 | 2022.01.05
備 註 | | 分 頁 | 1/2
