p20130222/test/得利卡-車頂燈架 - 複製/成品版本/生產單_22.07.14/短-車頂燈架-組合(v220714)/hihi.pdf

視圖149 ( 1 : 2 )

L

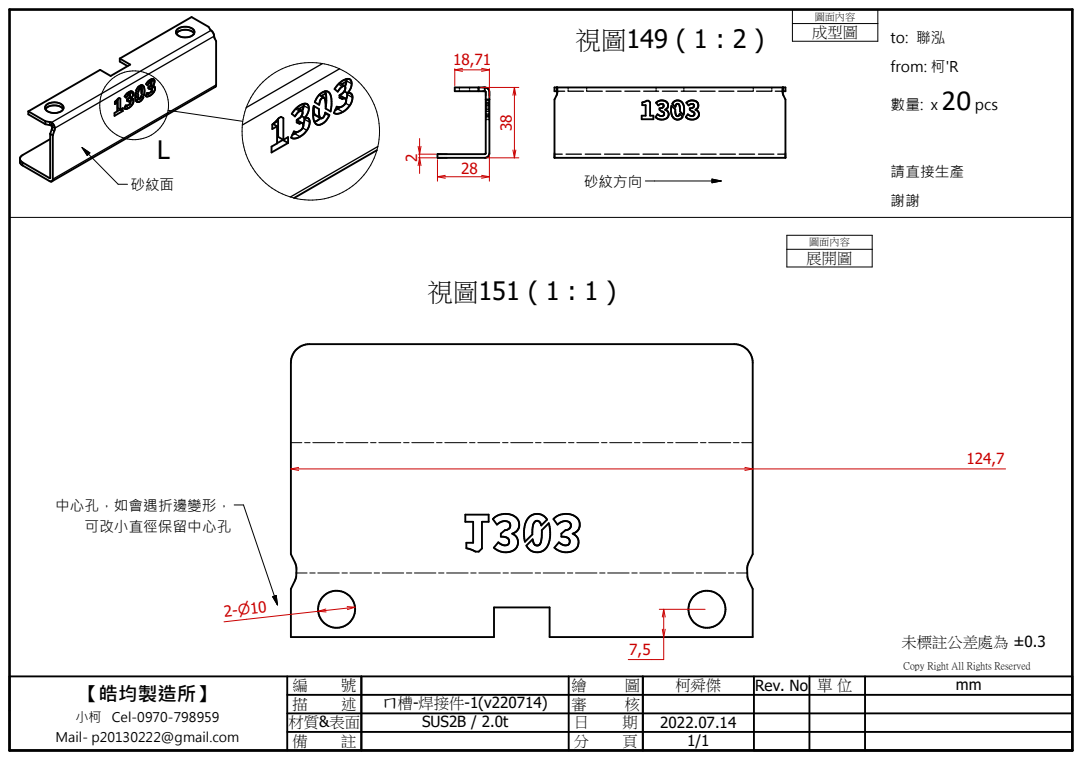
[picture p41: page 1]
未標註公差處為 ±0.3; 圖面內容 成型圖 38; 圖面內容 展開圖; 中心孔，如會遇折邊變形， 可改小直徑保留中心孔; 砂紋面; 砂紋方向; to: 聯泓 from: 柯'R 數量: x 20 pcs; 請直接生產 謝謝

Copy Right All Rights Reserved

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

描 述 | ㄇ槽-焊接件-1(v220714) | 審 核
材質&表面 | SUS2B / 2.0t | 日 期 | 2022.07.14
備 註 | | 分 頁 | 1/1
