p20130222/test/得利卡-車頂燈架 - 複製/成品版本/生產單_22.07.14/短-車頂燈架-組合(v220714)/吊架-短-焊接件-1(v220714)(頁1).pdf

## to: 聯泓 from: 柯'R

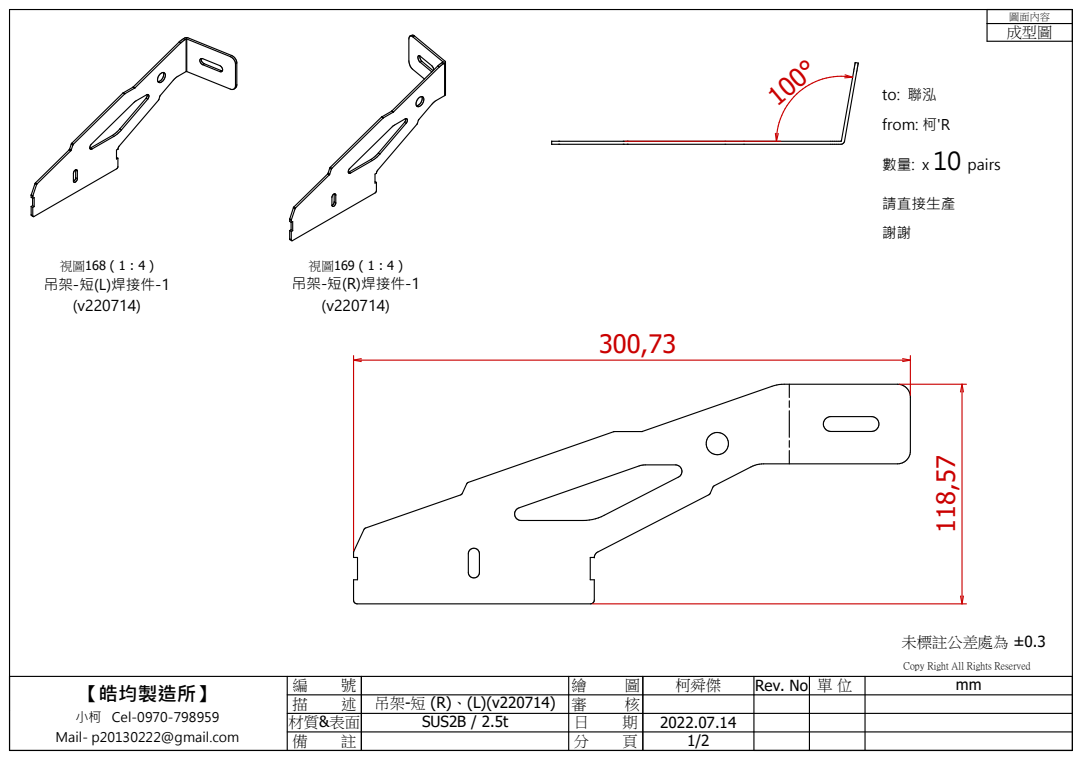
[picture p42: page 1]
視圖168 ( 1 : 4 ) 吊架-短(L)焊接件-1 (v220714); 視圖169 ( 1 : 4 ) 吊架-短(R)焊接件-1 (v220714); 未標註公差處為 ±0.3; 數量: x 10 pairs; 請直接生產 謝謝; 圖面內容 成型圖

Copy Right All Rights Reserved

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

描 述 | 吊架-短 (R)、(L)(v220714) | 審 核
材質&表面 | SUS2B / 2.5t | 日 期 | 2022.07.14
備 註 | | 分 頁 | 1/2
