p20130222/test/得利卡-車頂燈架 - 複製/成品版本/生產單_22.07.14/短-車頂燈架-組合(v220714)/吊架-短-焊接件-2(v220714).pdf

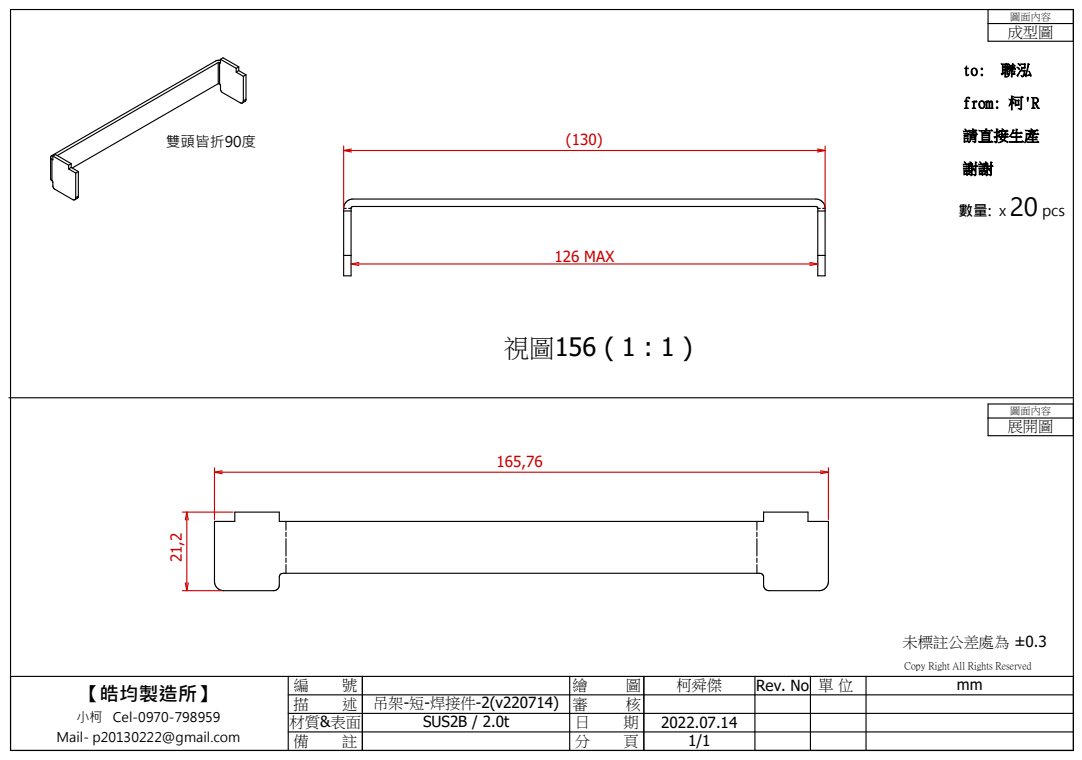
[picture p43: page 1]
未標註公差處為 ±0.3; from: 柯'R; 請直接生產; 圖面內容 成型圖; 圖面內容 展開圖; 數量: x 20 pcs; 雙頭皆折90度; 126 MAX

Copy Right All Rights Reserved

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

描 述 | 吊架-短-焊接件-2(v220714) | 審 核
材質&表面 | SUS2B / 2.0t | 日 期 | 2022.07.14
備 註 | | 分 頁 | 1/1
