p20130222/test/得利卡-車頂燈架 - 複製/OLD/模型、圖面/補角片(個案處理用)/補角片.pdf

#準

## to:聯泓

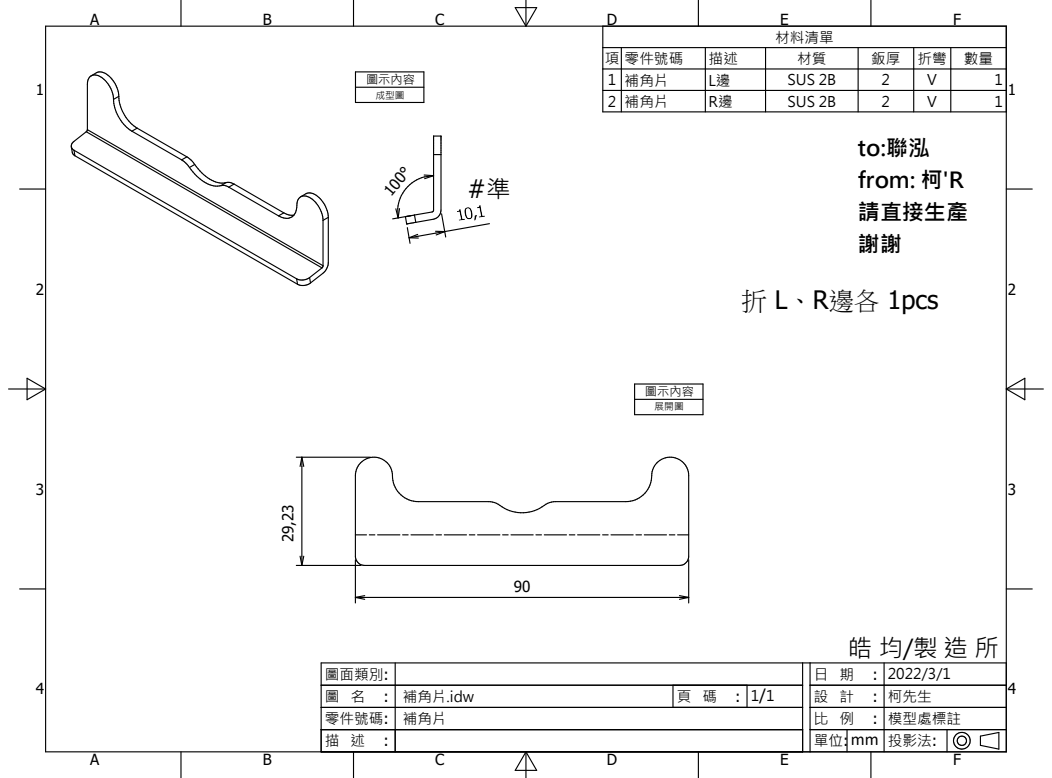
[picture p44: page 1]
補角片; SUS 2B; 圖示內容 成型圖; 展開圖; 圖示內容; from: 柯'R 請直接生產 謝謝; 折 L、R邊各 1pcs

材料清單

項 零件號碼 | | 描述 | 材質 | 鈑厚 | 折彎 | 數量

圖面類別: | | | 日 期 : | 2022/3/1
圖 名 : | 補角片.idw | 頁 碼 : | 1/1 | | 設 計 : | 柯先生
零件號碼: | 補角片 | | | | 比 例 : | 模型處標註
描 述 : | | | 單位: | mm | 投影法:
