p20130222/test/得利卡-車頂燈架 - 複製/OLD/詢、報價-資料/OLD/吊架-長 (R)、(L).pdf

## to: 聯泓 from: 柯'R

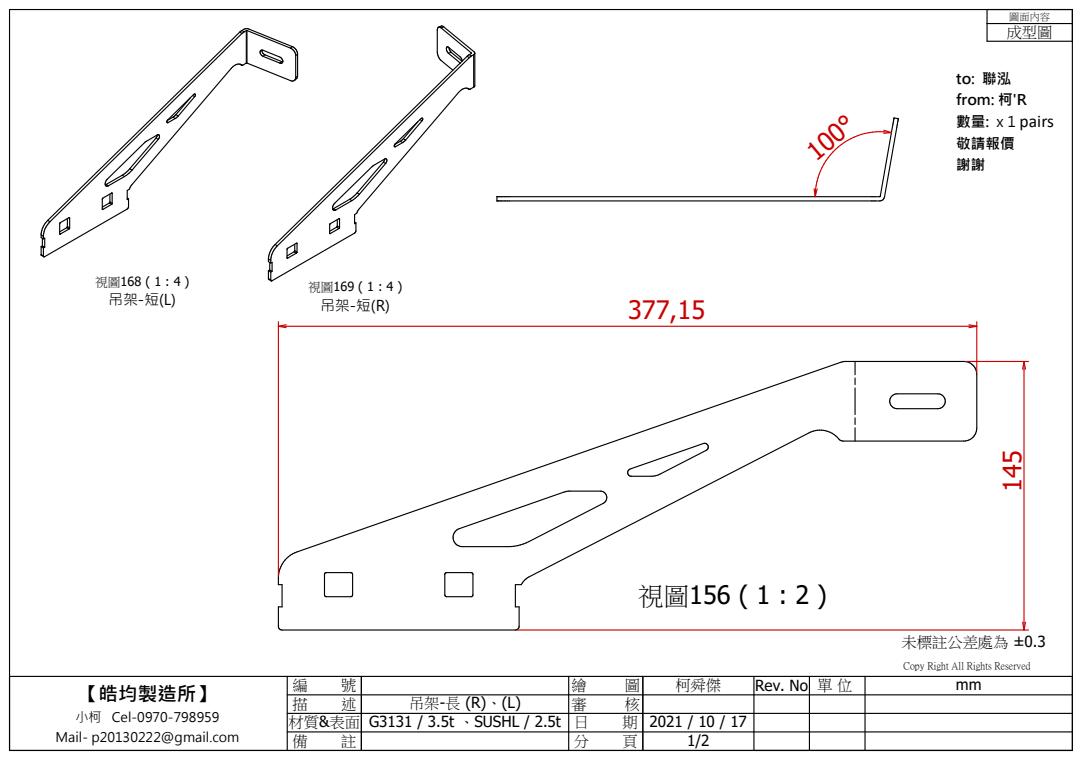
[picture p45: page 1]
未標註公差處為 ±0.3; 數量: x 1 pairs 敬請報價 謝謝; 圖面內容 成型圖

Copy Right All Rights Reserved

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

描 述 | 吊架-長 (R)、(L) | 審 核
材質&表面 | G3131 / 3.5t 、SUSHL / 2.5t | 日 期 | 2021 / 10 / 17
備 註 | | 分 頁 | 1/2
