p20130222/test/得利卡-車頂燈架 - 複製/OLD/詢、報價-資料/OLD/吊架組件-ㄇ槽.pdf

視圖149 ( 1 : 2 )

L

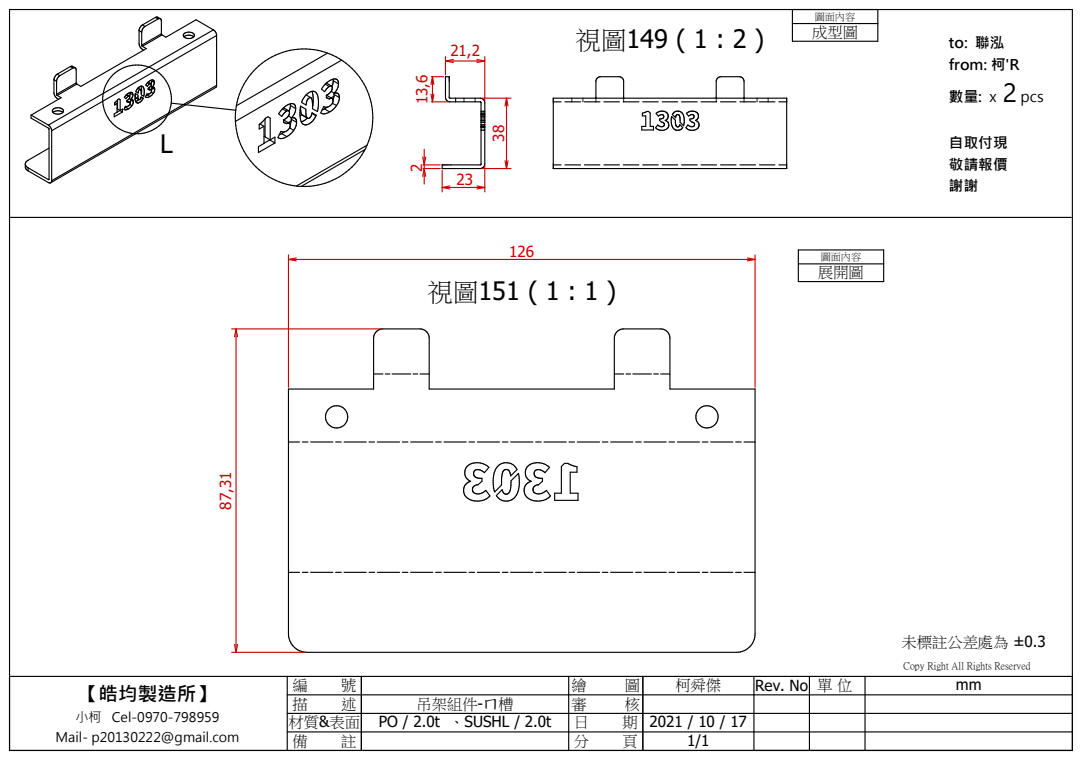
[picture p46: page 1]
未標註公差處為 ±0.3; to: 聯泓 from: 柯'R 數量: x 2 pcs; 自取付現 敬請報價 謝謝; 圖面內容 成型圖 38; 圖面內容 展開圖

Copy Right All Rights Reserved

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

描 述 | 吊架組件-ㄇ槽 | 審 核
材質&表面 | PO / 2.0t 、SUSHL / 2.0t | 日 期 | 2021 / 10 / 17
備 註 | | 分 頁 | 1/1
