p20130222/test/得利卡-車頂燈架 - 複製/OLD/模型、圖面/old/21.11.28_生產圖面/焊接組件(全)(#11.02).pdf

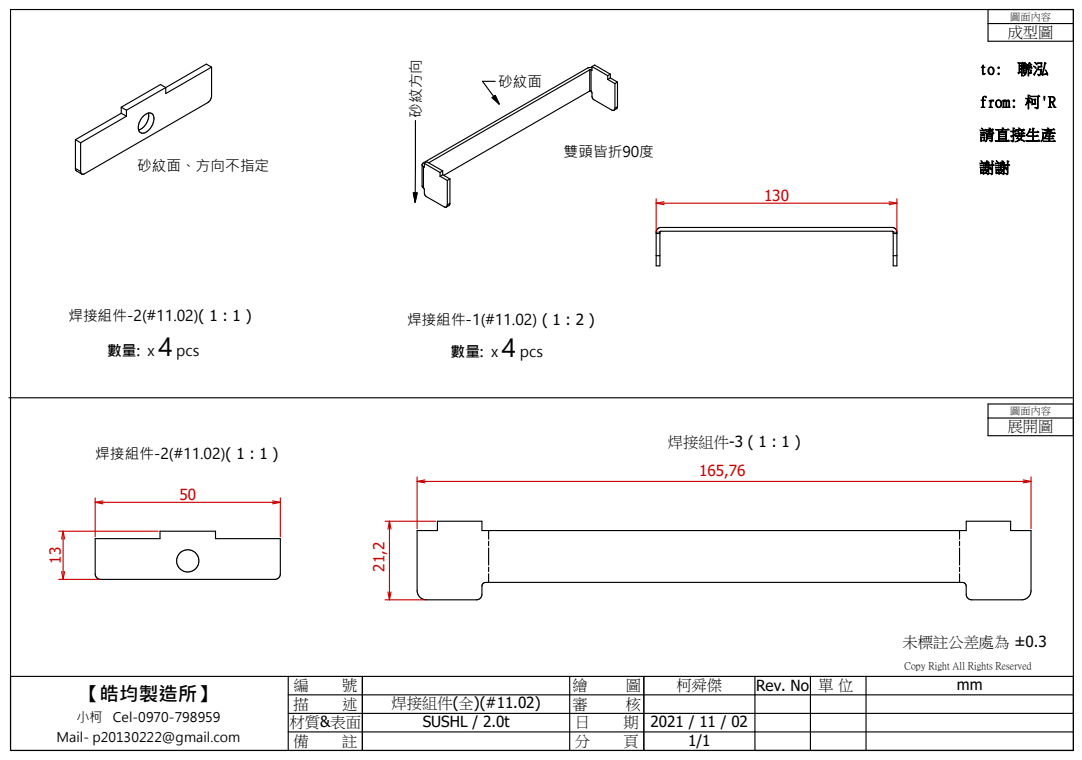
[picture p47: page 1]
焊接組件-1(#11.02) ( 1 : 2 ); 焊接組件-3 ( 1 : 1 ) 焊接組件-2(#11.02)( 1 : 1 ); 焊接組件-2(#11.02)( 1 : 1 ); 未標註公差處為 ±0.3; from: 柯'R; 請直接生產; 圖面內容 成型圖; 圖面內容 展開圖; 數量: x 4 pcs; 雙頭皆折90度; 砂紋面 砂紋方向; 砂紋面、方向不指定

Copy Right All Rights Reserved

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

描 述 | 焊接組件(全)(#11.02) | 審 核
材質&表面 | SUSHL / 2.0t | 日 期 | 2021 / 11 / 02
備 註 | | 分 頁 | 1/1
