p20130222/test/得利卡-車頂燈架 - 複製/OLD/模型、圖面/old/烤漆治具-焊接用/烤漆治具-焊接用.pdf

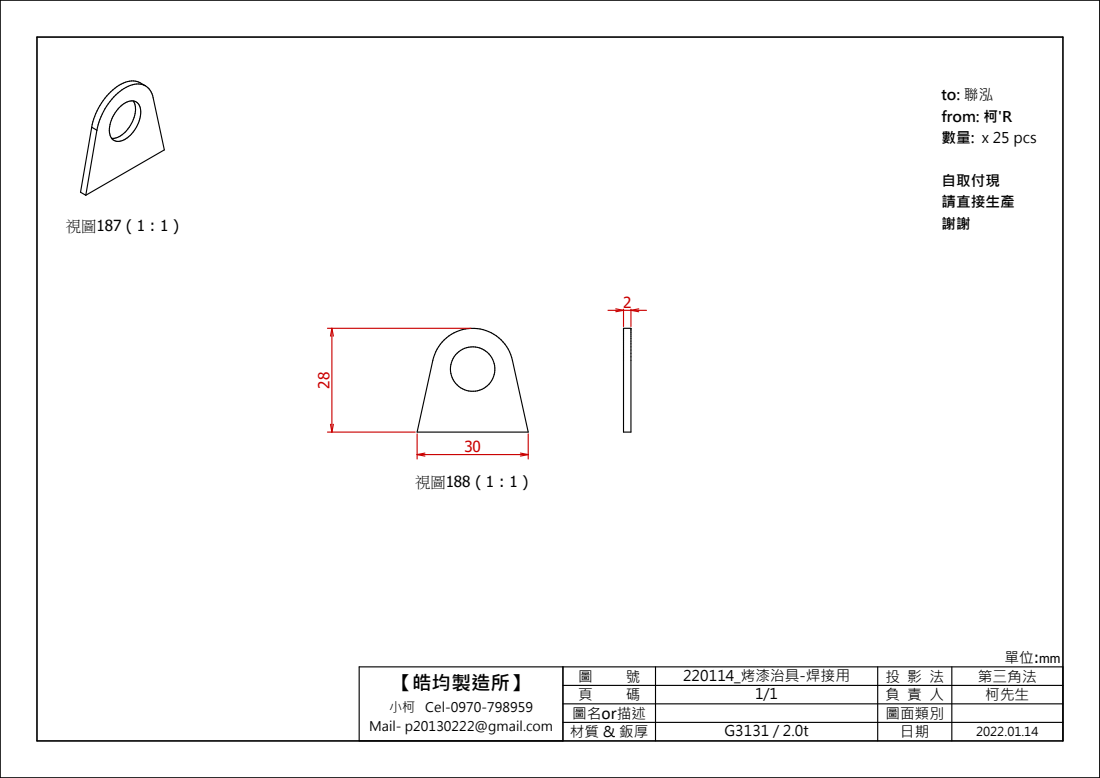
[picture p48: page 1]
to: 聯泓 from: 柯'R 數量: x 25 pcs; 自取付現 請直接生產 謝謝

【皓均製造所】 小柯 Cel-0970-798959 Mail- p20130222@gmail.com | 圖 號 | 220114_烤漆治具-焊接用 | 投 影 法 | 第三角法

頁 碼 | 1/1 | 負 責 人 | 柯先生
圖名or描述 | | 圖面類別
材質 & 鈑厚 | G3131 / 2.0t | 日期 | 2022.01.14
