p20130222/test/得利卡-車頂燈架 - 複製/OLD/模型、圖面/版本-吊架-長(#11.26)/OLD/作廢--吊架-長(#11.26).pdf

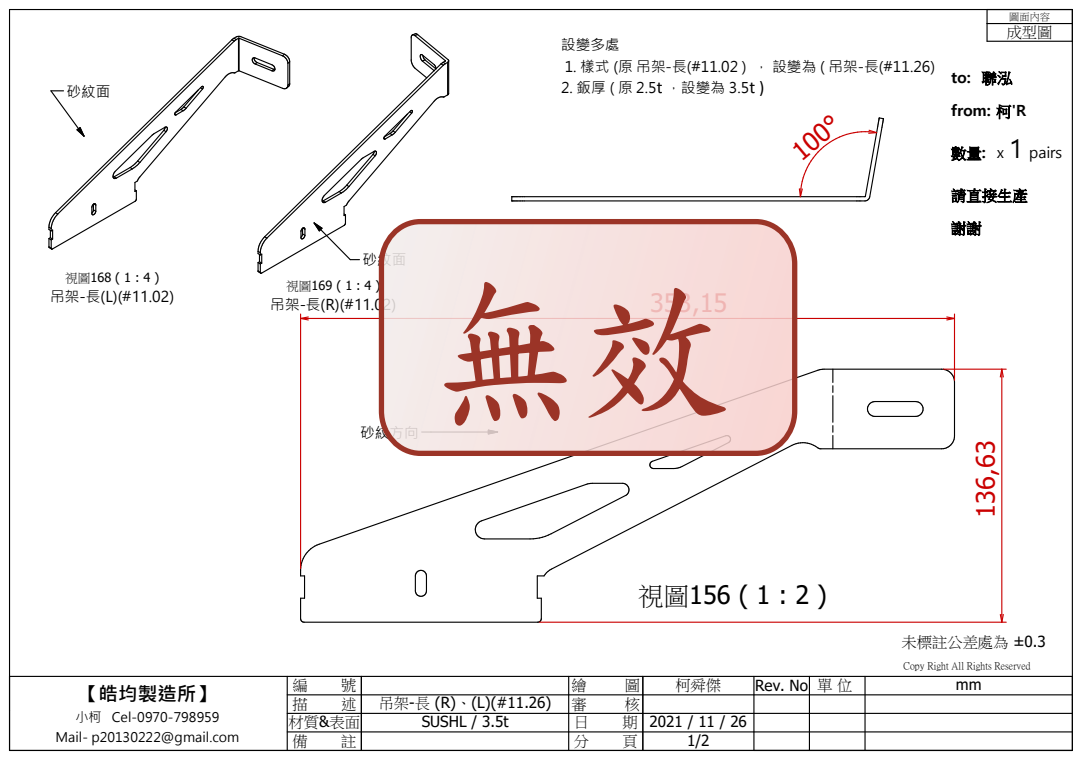
[picture p49: page 1]
未標註公差處為 ±0.3; 圖面內容 成型圖; from: 柯'R; 數量: x 1 pairs; 請直接生產; 砂紋面; 砂紋方向

設變多處
1. 樣式 (原 吊架-⾧(#11.02 ) ， 設變為 ( 吊架-⾧(#11.26)
2. 鈑厚 ( 原 2.5t ，設變為 3.5t )

Copy Right All Rights Reserved

【皓均製造所】 小柯 Cel-0970-798959 Mail- p20130222@gmail.com | 編 號 | | 繪 圖 | 柯舜傑 | Rev. No | 單 位 | mm

描 述 | 吊架-長 (R)、(L)(#11.26) | 審 核
材質&表面 | SUSHL / 3.5t | 日 期 | 2021 / 11 / 26
備 註 | | 分 頁 | 1/2

,

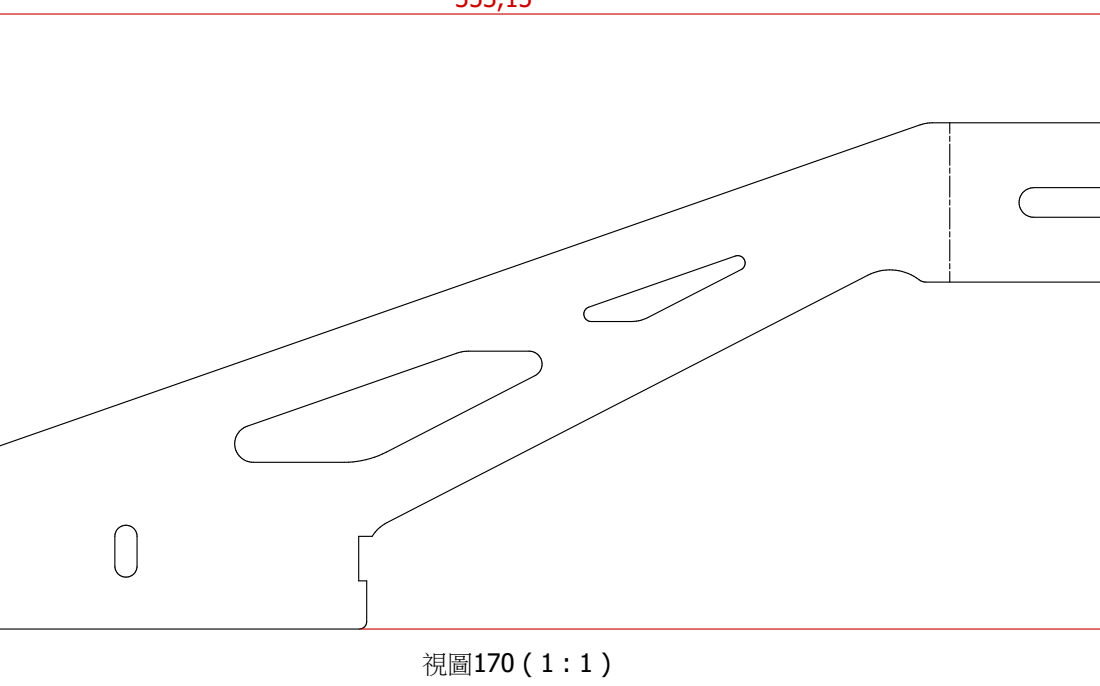
[picture p50: page 2]
