p20130222/test/得利卡-車頂燈架 - 複製/OLD/模型、圖面/版本-吊架-長(#11.26)/發出圖面/焊接組件-3( #11.26).pdf

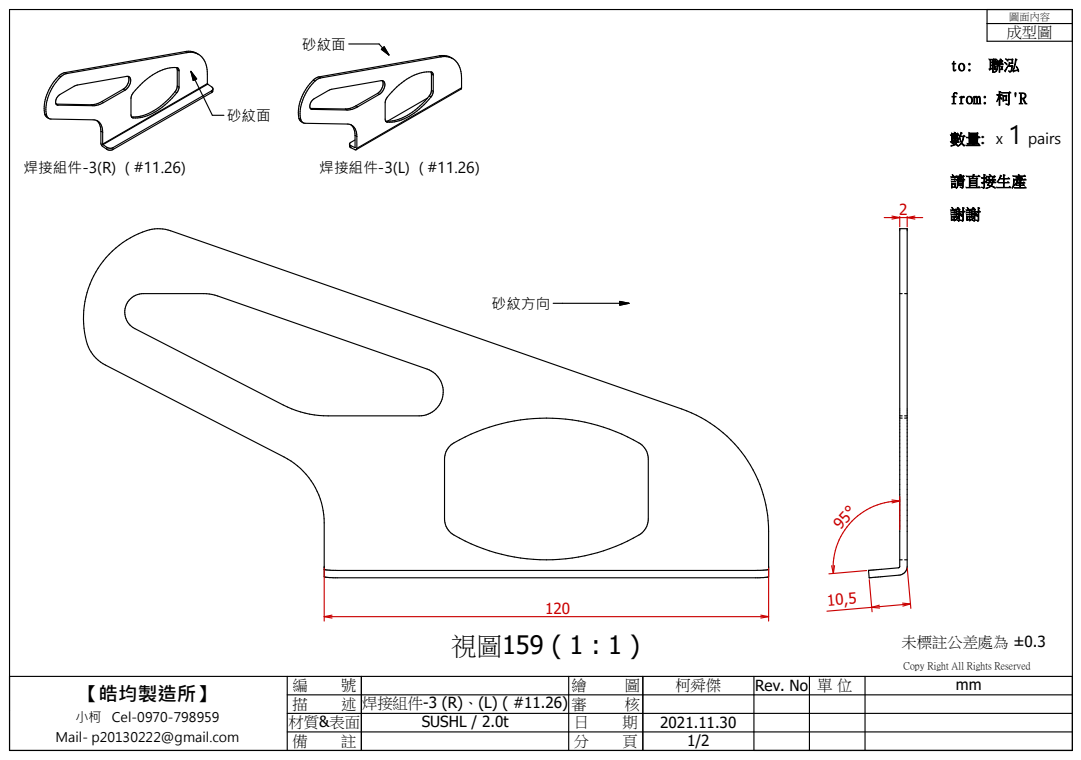
[picture p51: page 1]
未標註公差處為 ±0.3; from: 柯'R 數量: x 1 pairs; 請直接生產; 圖面內容 成型圖; 焊接組件-3(R) ( #11.26); 焊接組件-3(L) ( #11.26); 砂紋面; 砂紋方向

Copy Right All Rights Reserved

【皓均製造所】 小柯 Cel-0970-798959 Mail- p20130222@gmail.com | 編 號 | | 繪 圖 | 柯舜傑 | Rev. No | 單 位 | mm

描 述 | 焊接組件-3 (R)、(L) ( #11.26) | 審 核
材質&表面 | SUSHL / 2.0t | 日 期 | 2021.11.30
備 註 | | 分 頁 | 1/2

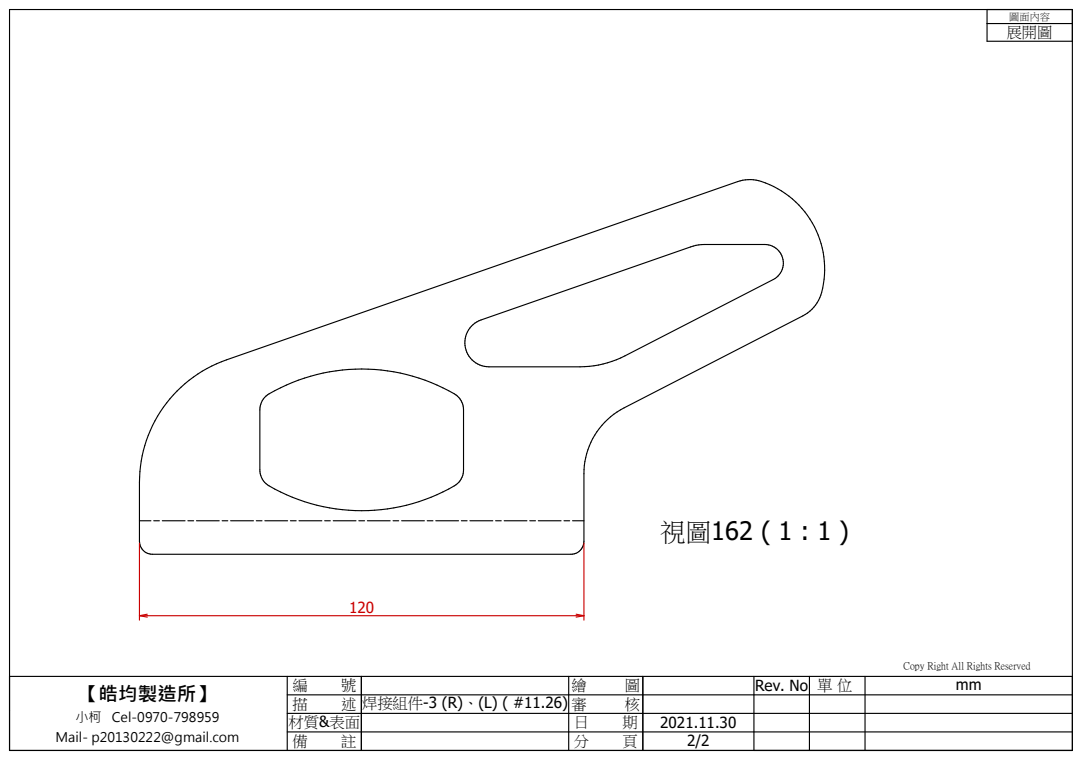
[picture p52: page 2]
圖面內容 展開圖

Copy Right All Rights Reserved

【皓均製造所】 小柯 Cel-0970-798959 Mail- p20130222@gmail.com | 編 號 | | 繪 圖 | | Rev. No | 單 位 | mm

描 述 | 焊接組件-3 (R)、(L) ( #11.26) | 審 核
材質&表面 | | 日 期 | 2021.11.30
備 註 | | 分 頁 | 2/2
