p20130222/test/得利卡-車頂燈架 - 複製/OLD/模型、圖面/old/短-車頂燈架-組合(#11.02)/生產圖面_21.11.26/吊架-短(#11.02).pdf

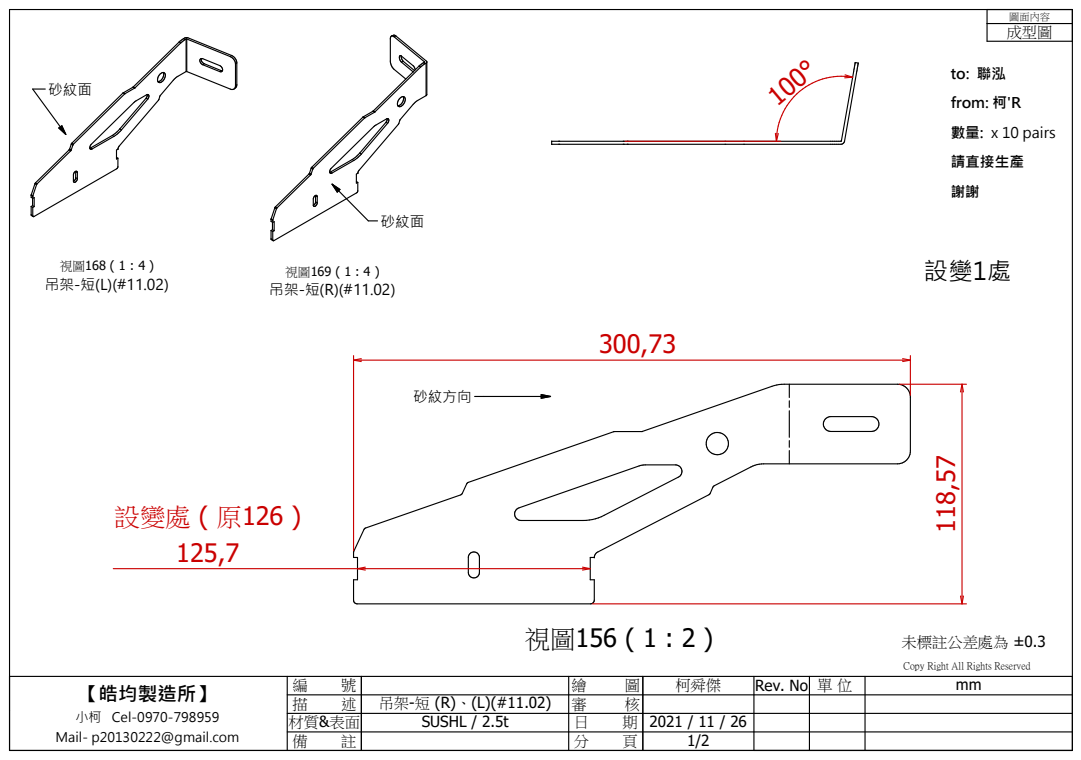
[picture p53: page 1]
未標註公差處為 ±0.3; to: 聯泓 from: 柯'R; 數量: x 10 pairs; 請直接生產; 圖面內容 成型圖; 砂紋面; 砂紋方向; 設變處 ( 原126 )

Copy Right All Rights Reserved

【皓均製造所】 小柯 Cel-0970-798959 Mail- p20130222@gmail.com | 編 號 | | 繪 圖 | 柯舜傑 | Rev. No | 單 位 | mm

描 述 | 吊架-短 (R)、(L)(#11.02) | 審 核
材質&表面 | SUSHL / 2.5t | 日 期 | 2021 / 11 / 26
備 註 | | 分 頁 | 1/2

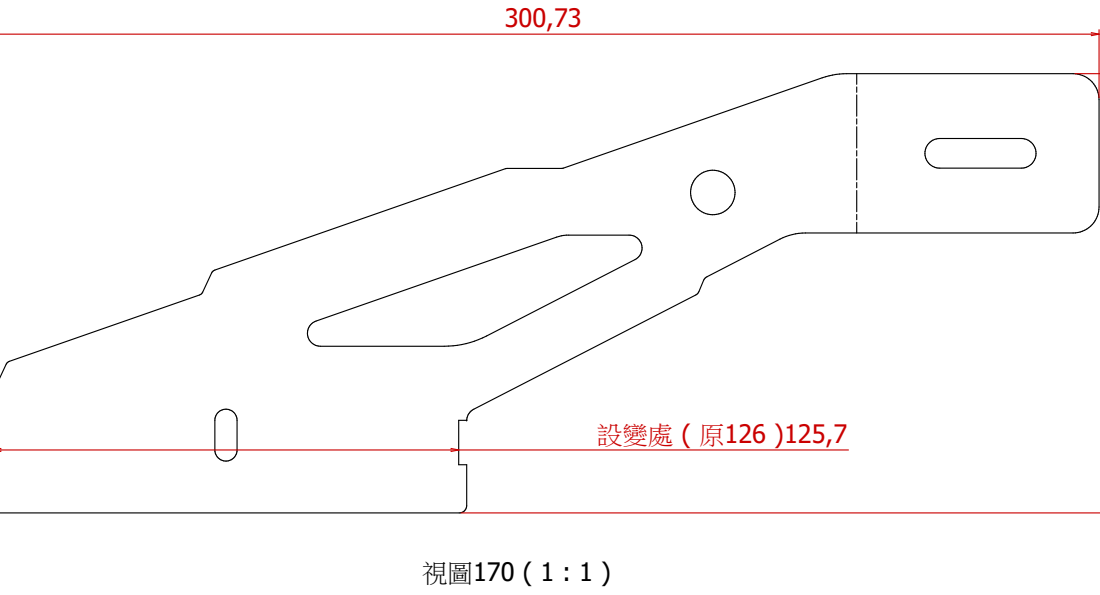
[picture p54: page 2]
設變處 ( 原126 )125,7
