p20130222/test/得利卡-車頂燈架 - 複製/OLD/模型、圖面/old/短-車頂燈架-組合(#11.02)/生產圖面_21.11.26/烤漆-短-車頂燈架-組合(#11.02).pdf

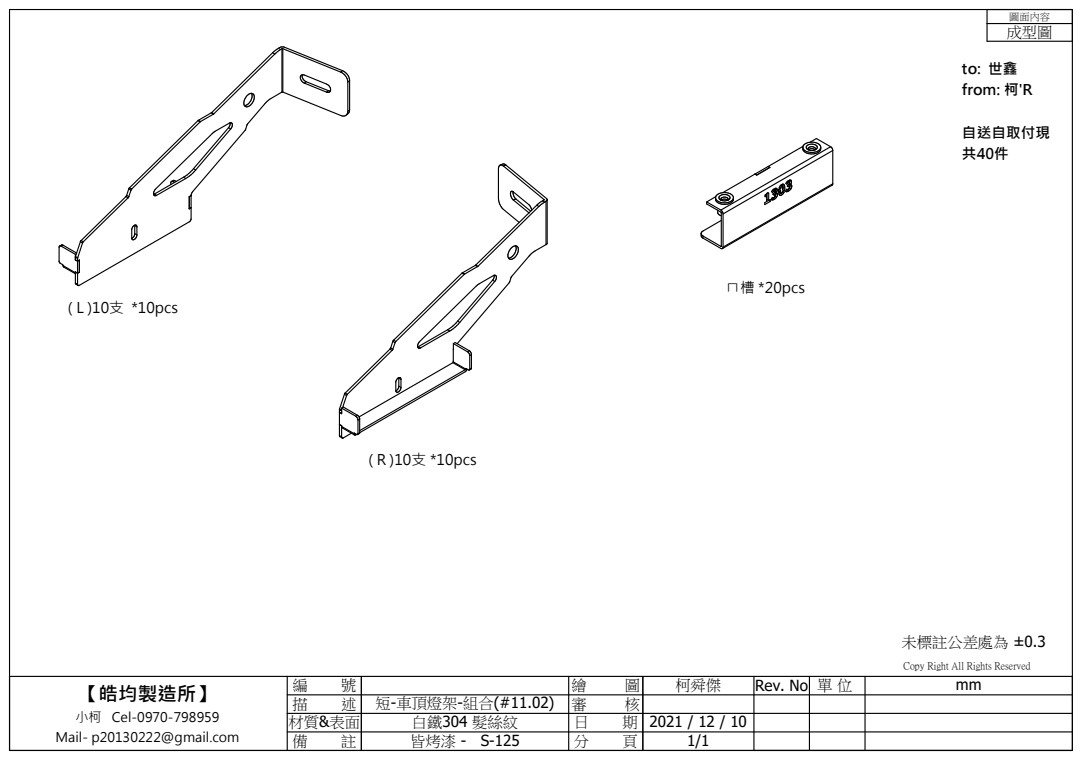
[picture p55: page 1]
未標註公差處為 ±0.3; 圖面內容 成型圖; ㄇ槽 *20pcs; ( R )10支 *10pcs; ( L )10支 *10pcs; to: 世鑫 from: 柯'R; 自送自取付現 共40件

Copy Right All Rights Reserved

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

描 述 | 短-車頂燈架-組合(#11.02) | 審 核
材質&表面 | 白鐵304 髮絲紋 | 日 期 | 2021 / 12 / 10
備 註 | 皆烤漆 - S-125 | 分 頁 | 1/1
