p20130222/test/(commit log)

2022-12-17 新增專案檔案
    [#3.0022.ipt, LOGO-1303字體.0003.ipt, old ( 草-組合檔 ).0102.iam, old ( 草-組合檔 ).iam, ㄇ槽(#01.05)- 焊接組合.0010.iam, ㄇ槽(#01.05)- 焊接組合.iam, ㄇ槽- 焊接組合(v220714).0013.iam, ㄇ槽- 焊接組合(v220714).iam]
2022-12-17 新增複製檔案
    [ㄇ槽-焊接件-1(v220714) - 複製.ipt]
2022-12-17 加寬尺寸
    127變動到200
    [ㄇ槽-焊接件-1(v220714) - 複製.0132.ipt, ㄇ槽-焊接件-1(v220714) - 複製.ipt]
2022-12-17 更新ㄇ曹物件
    更新
    [--ㄇ槽-焊接件-1(v220714).ipt, ㄇ槽-焊接件-1(v220714).0268.idw, ㄇ槽-焊接件-1(v220714).0269.idw, ㄇ槽-焊接件-1(v220714).idw]
2022-12-17 新增 PDF
    HIHI
